dwatman/weather-station/PCB/display_wifi/display_wifi.kicad_pcb

## KiCad design PCB/display_wifi/display_wifi.kicad_pcb (2026-01-17)

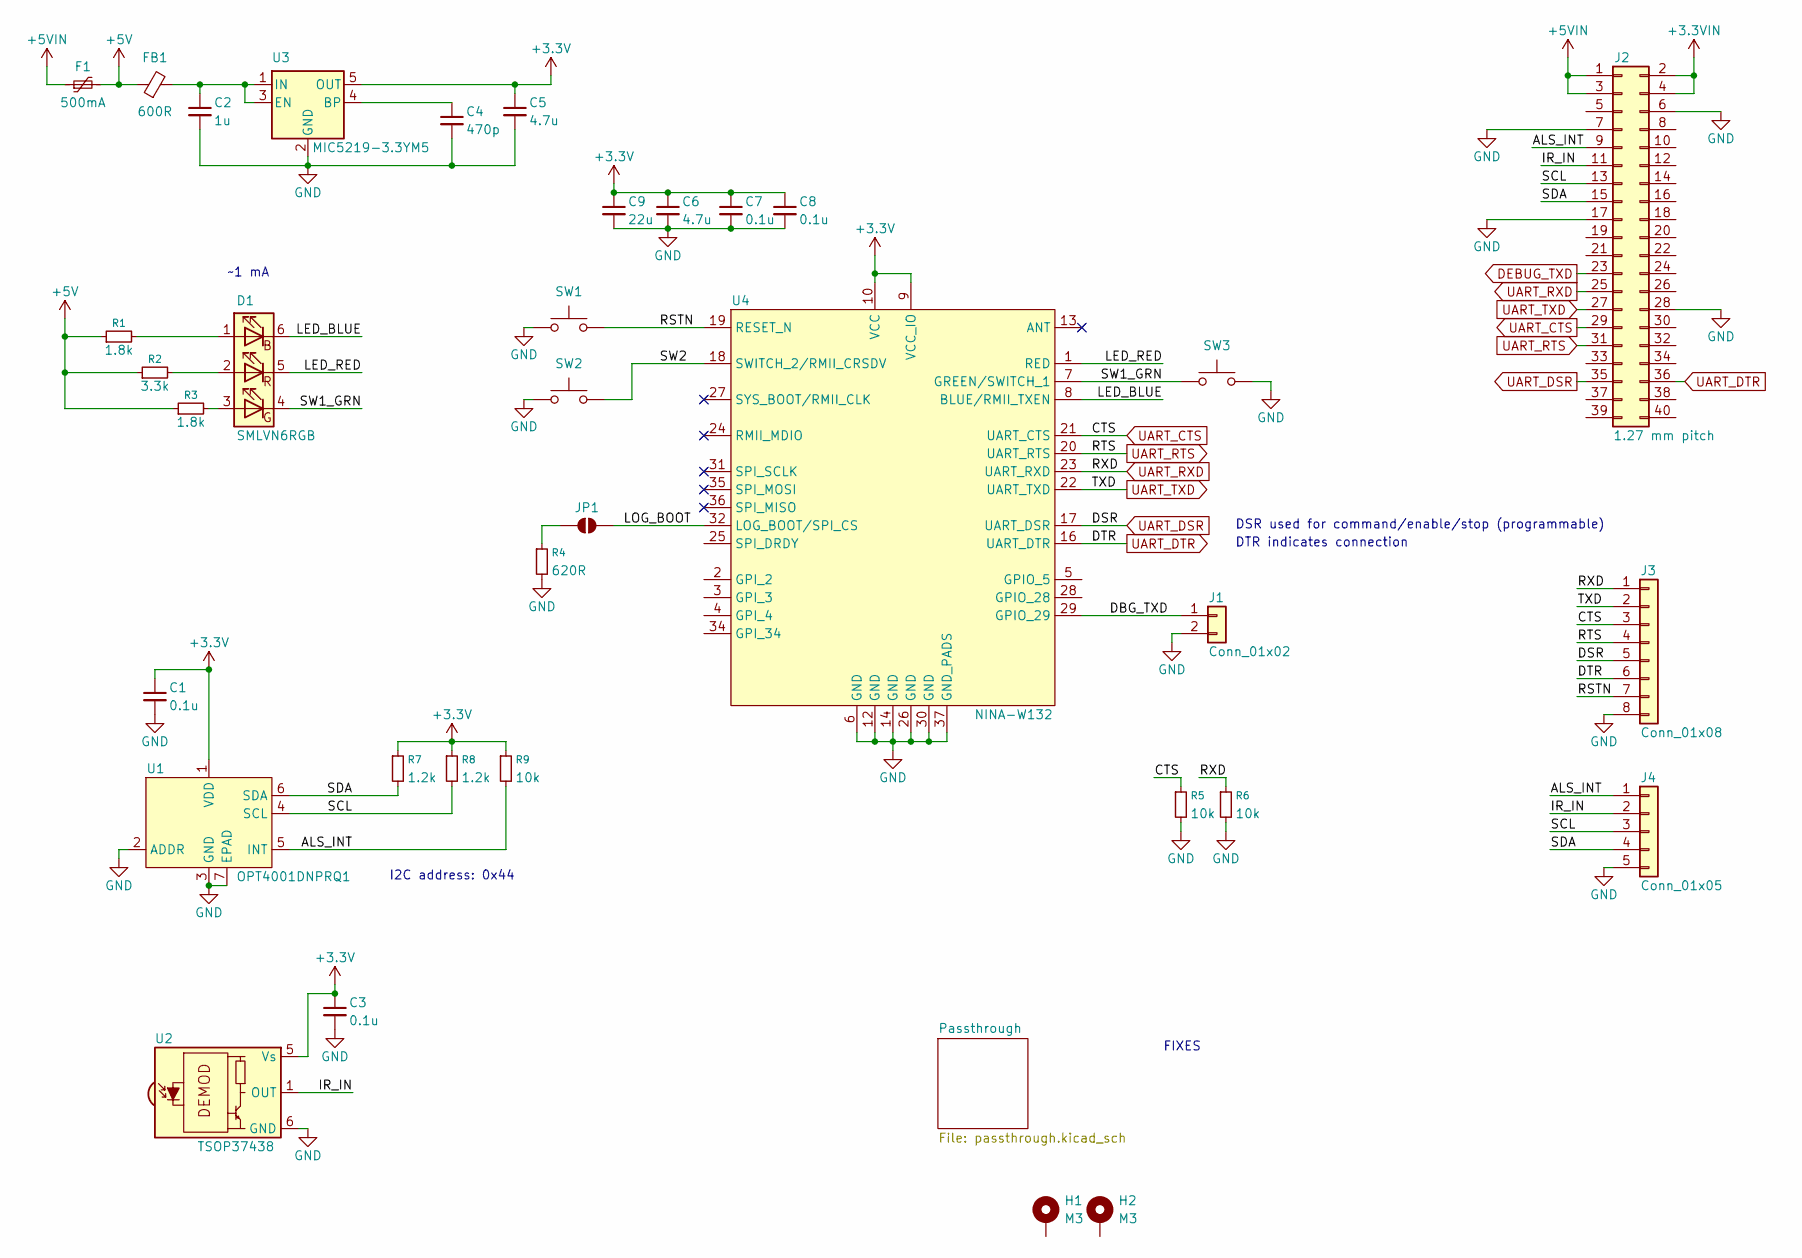
[picture p1: schematic display_wifi.kicad_sch, Wi-Fi Interface for Display]

Parts:
C1, C3, C7, C8: 0.1u; C_0402_1005Metric; MPN CL05B104KA5NNNC; Mouser PN 187-CL05B104KA5NNNC
C2: 1u; C_0402_1005Metric; MPN CL05A105KA5NQNC; Mouser PN 187-CL05A105KA5NQNC
C4: 470p; C_0402_1005Metric; MPN GRM1555C2A471JE01D; Mouser PN 81-GRM1555C2A471JE1D
C5, C6: 4.7u; C_0603_1608Metric; MPN CL10A475KO8NNNC; Mouser PN 187-CL10A475KO8NNNC
C9: 22u; C_1210_3225Metric
D1: SMLVN6RGB; LED_ROHM_SMLVN6; MPN SMLVN6RGB7W1; Mouser PN 755-SMLVN6RGB7W1
F1: 500mA; Fuse_1206_3216Metric; MPN MF-NSMF050-2; Mouser PN 652-MF-NSMF050-2
FB1: 600R; L_0805_2012Metric; MPN BLM21SP601SZ1D; Mouser PN 81-BLM21SP601SZ1D
H1, H2: M3; MountingHole_3.2mm_M3_Pad
J1: Conn_01x02; PinHeader_1x02_P2.54mm_Vertical
J2: 1.27 mm pitch; PinSocket_2x20_P1.27mm_Vertical; MPN 20021311-00040T4LF; Mouser PN 649-221311-00040T4LF
J3: Conn_01x08; PinHeader_1x08_P2.54mm_Vertical
J4: Conn_01x05; PinHeader_1x05_P2.54mm_Vertical
JP1: SolderJumper_2_Open; SolderJumper-2_P1.3mm_Open_TrianglePad1.0x1.5mm
R1, R3: 1.8k; R_0603_1608Metric
R2: 3.3k; R_0603_1608Metric
R4: 620R; R_0603_1608Metric
R5, R6, R9: 10k; R_0603_1608Metric
R7, R8: 1.2k; R_0603_1608Metric
SW1, SW2, SW3: TL3305; SW_Push_1P1T_NO_E-Switch_TL3305AFxxxQG; MPN TL3305BF100QG; Mouser PN 612-TL3305BF100QG
U1: OPT4001DNPRQ1; TI_USON-6-1EP_2x2mm_P0.5mm_EP0.65x1.35mm; MPN OPT4001DNPRQ1; Mouser PN 595-OPT4001DNPRQ1
U2: TSOP37438; Vishay_BELOBOG-4Pin; MPN TSOP37438TT1; Mouser PN 78-TSOP37438TT1
U3: MIC5219-3.3YM5; SOT-23-5; MPN MIC5219-3.3YM5-TR; Mouser PN 998-MIC5219-3.3YM5TR
U4: NINA-W132; ublox_NINA-W1x2; MPN NINA-W132-03B; Mouser PN 377-NINA-W132-03B

Connections:
+3.3V: C1.1, C3.1, C5.1, C6.1, C7.1, C8.1, C9.1, R7.1, R8.1, R9.1, U1.1 (VDD), U2.5 (Vs), U3.5 (OUT), U4.9 (VCC_IO), U4.10 (VCC)
+3.3VIN: J2.2, J2.4
+5V: F1.2, FB1.1, R1.1, R2.1, R3.1
+5VIN: F1.1, J2.1, J2.3
/ALS_INT: J2.9, J4.1, R9.2, U1.5 (INT)
/DBG_TXD: J1.1, U4.29 (GPIO_29)
/IR_IN: J2.11, J4.2, U2.1 (OUT)
/LED_BLUE: D1.6 (BK), U4.8 (BLUE/RMII_TXEN)
/LED_RED: D1.5 (RK), U4.1 (RED)
/LOG_BOOT: JP1.2 (B), U4.32 (LOG_BOOT/SPI_CS)
/RSTN: J3.7, SW1.2, U4.19 (RESET_N)
/SCL: J2.13, J4.3, R8.2, U1.4 (SCL)
/SDA: J2.15, J4.4, R7.2, U1.6 (SDA)
/SW1_GRN: D1.4 (GK), SW3.1, U4.7 (GREEN/SWITCH_1)
/SW2: SW2.2, U4.18 (SWITCH_2/RMII_CRSDV)
DEBUG_TXD: J2.23; also elsewhere on the board
GND: C1.2, C2.2, C3.2, C4.2, C5.2, C6.2, C7.2, C8.2, C9.2, J1.2, J2.6, J2.7, J2.17, J2.28, J3.8, J4.5, R4.2, R5.2, R6.2, SW1.1, SW2.1, SW3.2, U1.2 (ADDR), U1.3 (GND), U1.7 (EPAD), U2.6 (GND), U2.8 (GND), U3.2 (GND), U4.6 (GND), U4.12 (GND), U4.14 (GND), U4.26 (GND), U4.30 (GND), U4.37 (GND_PADS); also elsewhere on the board
unnamed: D1.1 (BA), R1.2
unnamed: D1.3 (GA), R3.2
unnamed: D1.2 (RA), R2.2
unnamed: JP1.1 (A), R4.1
unnamed: C4.1, U3.4 (BP)
unnamed: C2.1, FB1.2, U3.1 (IN), U3.3 (EN)
UART_CTS: J2.29, J3.3, R5.1, U4.21 (UART_CTS)
UART_DSR: J2.35, J3.5, U4.17 (UART_DSR)
UART_DTR: J2.36, J3.6, U4.16 (UART_DTR)
UART_RTS: J2.31, J3.4, U4.20 (UART_RTS)
UART_RXD: J2.25, J3.1, R6.1, U4.23 (UART_RXD)
UART_TXD: J2.27, J3.2, U4.22 (UART_TXD)

Notes on the sheet:
DTR indicates connection
DSR used for command/enable/stop (programmable)
I2C address: 0x44
~1 mA
FIXES

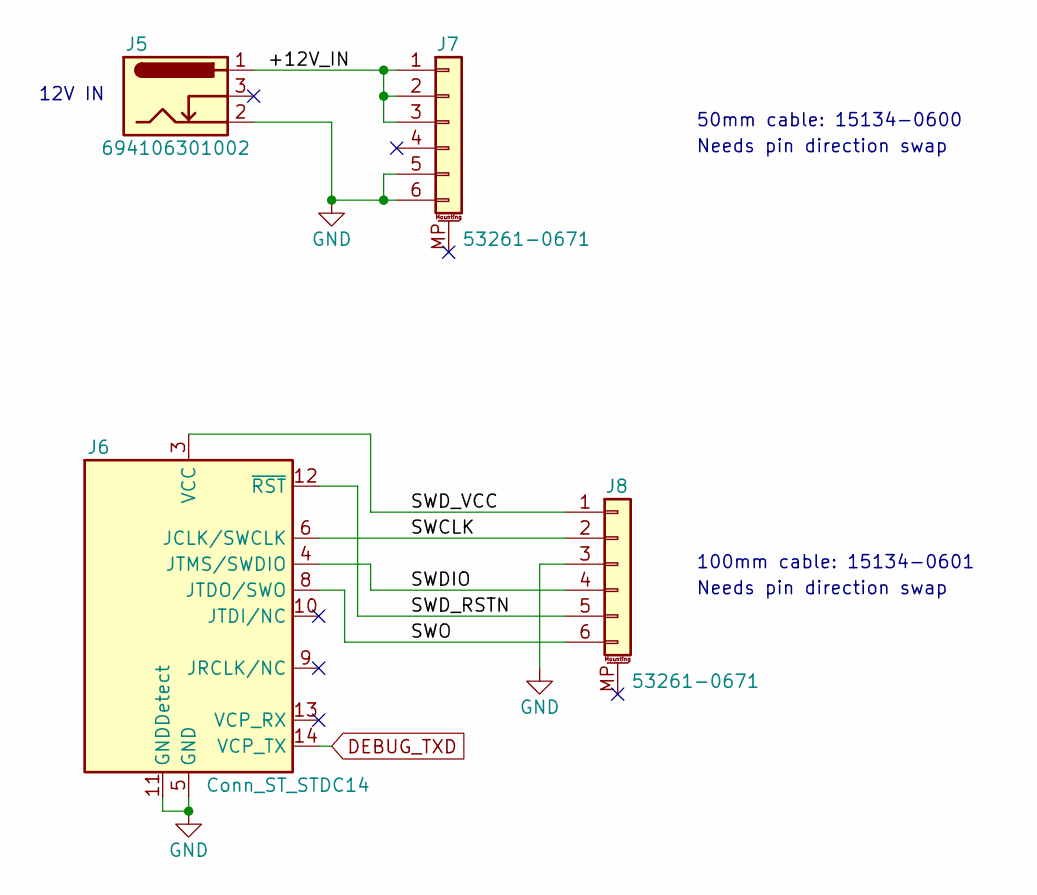
[picture p2: schematic passthrough.kicad_sch]

Parts:
J5: 694106301002; BarrelJack_Wuerth_6941xx301002; MPN 694106301002; Mouser PN 710-694106301002
J6: Conn_ST_STDC14; PinHeader_2x07_P1.27mm_Vertical; MPN 20021111-00014T1LF; Mouser PN 649-200211110014T1LF
J7, J8: 53261-0671; Molex_PicoBlade_53261-0671_1x06-1MP_P1.25mm_Horizontal; MPN 53261-0671; Mouser PN 538-53261-0671

Connections:
/Passthrough/+12V_IN: J5.1, J7.1, J7.2, J7.3
/Passthrough/SWCLK: J6.6 (JCLK/SWCLK), J8.2
/Passthrough/SWDIO: J6.4 (JTMS/SWDIO), J8.4
/Passthrough/SWD_RSTN: J6.12 (~RST), J8.5
/Passthrough/SWD_VCC: J6.3 (VCC), J8.1
/Passthrough/SWO: J6.8 (JTDO/SWO), J8.6
DEBUG_TXD: J6.14 (VCP_TX); also elsewhere on the board
GND: J5.2, J6.5 (GND), J6.7 (GND), J6.11 (GNDDetect), J7.5, J7.6, J8.3; also elsewhere on the board

Notes on the sheet:
50mm cable: 15134-0600
Needs pin direction swap
100mm cable: 15134-0601
12V IN

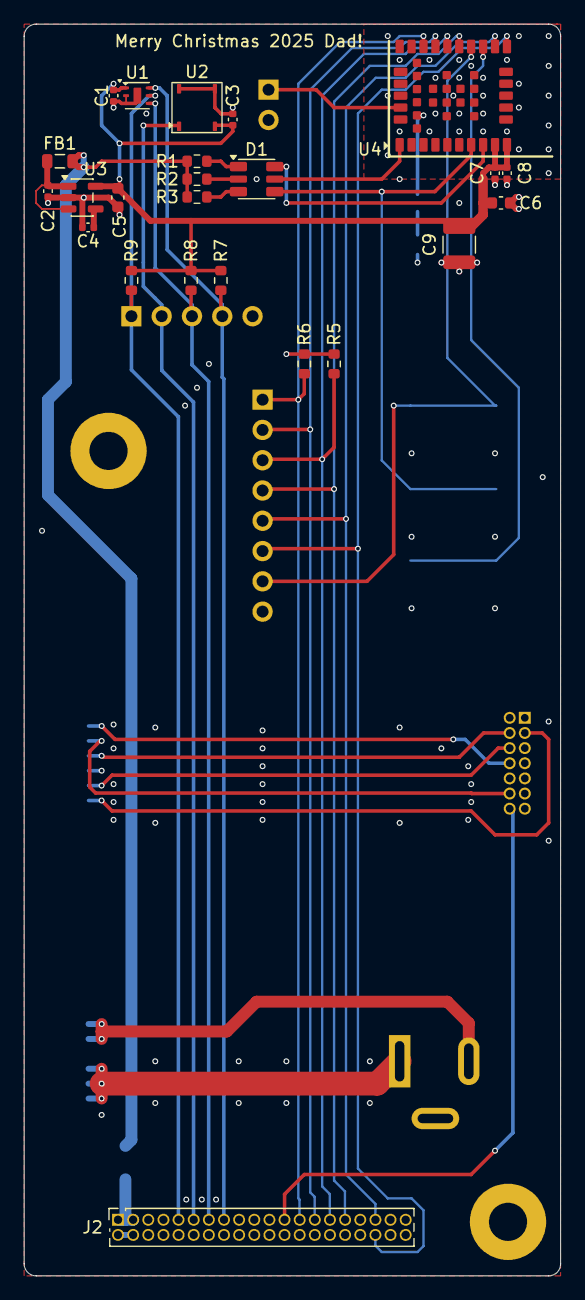
[picture p3: board display_wifi.kicad_pcb from above]

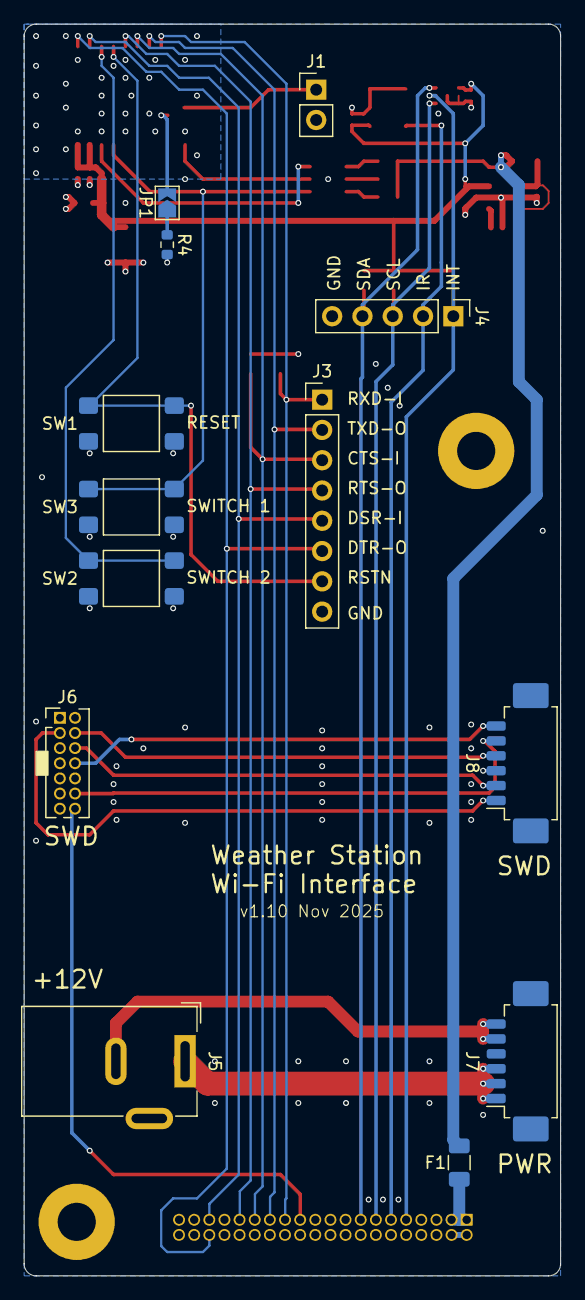
[picture p4: board display_wifi.kicad_pcb from below]

Board: 2 copper layers, 45.0 x 105.0 mm, 39 parts (13 on the bottom side), 35 nets.
