dwatman/weather-station/PCB/sensors_outdoor/sensors_outdoor.kicad_pcb

## KiCad design PCB/sensors_outdoor/sensors_outdoor.kicad_pcb (2025-11-24)

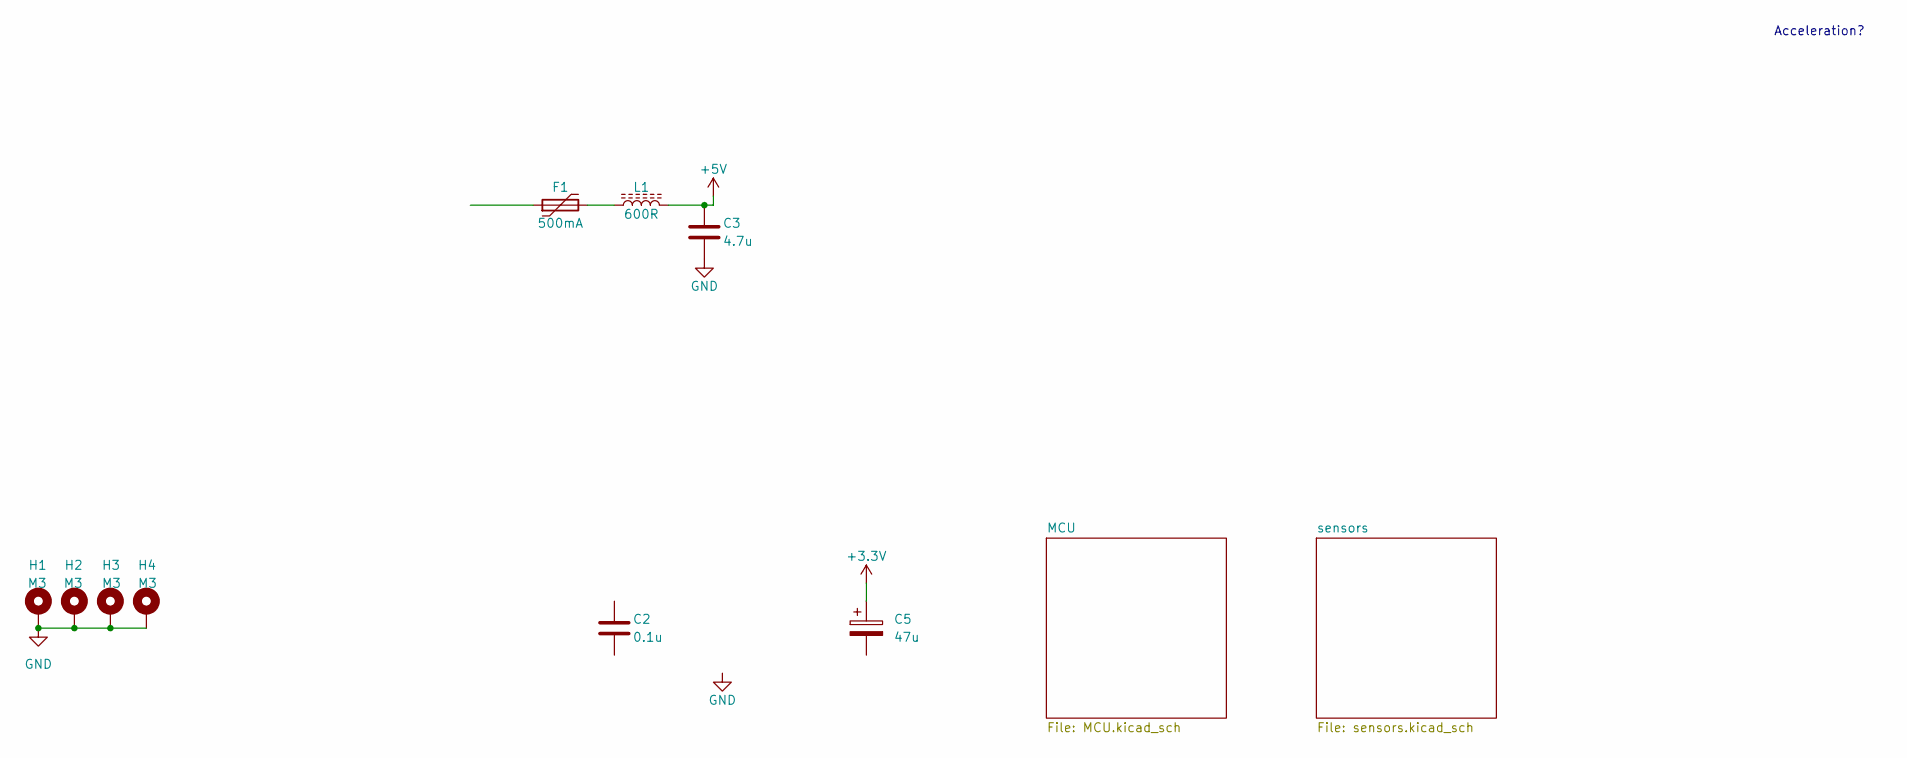
[picture p5: schematic sensors_outdoor.kicad_sch, Outdoor Sensor Board]

Parts:
C2: 0.1u; C_0402_1005Metric
C3: 4.7u; C_0805_2012Metric
C5: 47u; CP_EIA-7343-31_Kemet-D; MPN T491D476K010AT; Mouser PN 80-T491D476K010
F1: 500mA; Fuse_0805_2012Metric
H1, H2, H3, H4: M3; MountingHole_3.2mm_M3_Pad
L1: 600R; L_0805_2012Metric; MPN HZ0805E601R-10; Mouser PN 875-HZ0805E601R-10

Connections:
+3.3V: C5.1; also elsewhere on the board
+5V: C3.1, L1.2
GND: C3.2, H1.1, H2.1, H3.1, H4.1; also elsewhere on the board
unnamed: F1.2, L1.1

Notes on the sheet:
Acceleration?

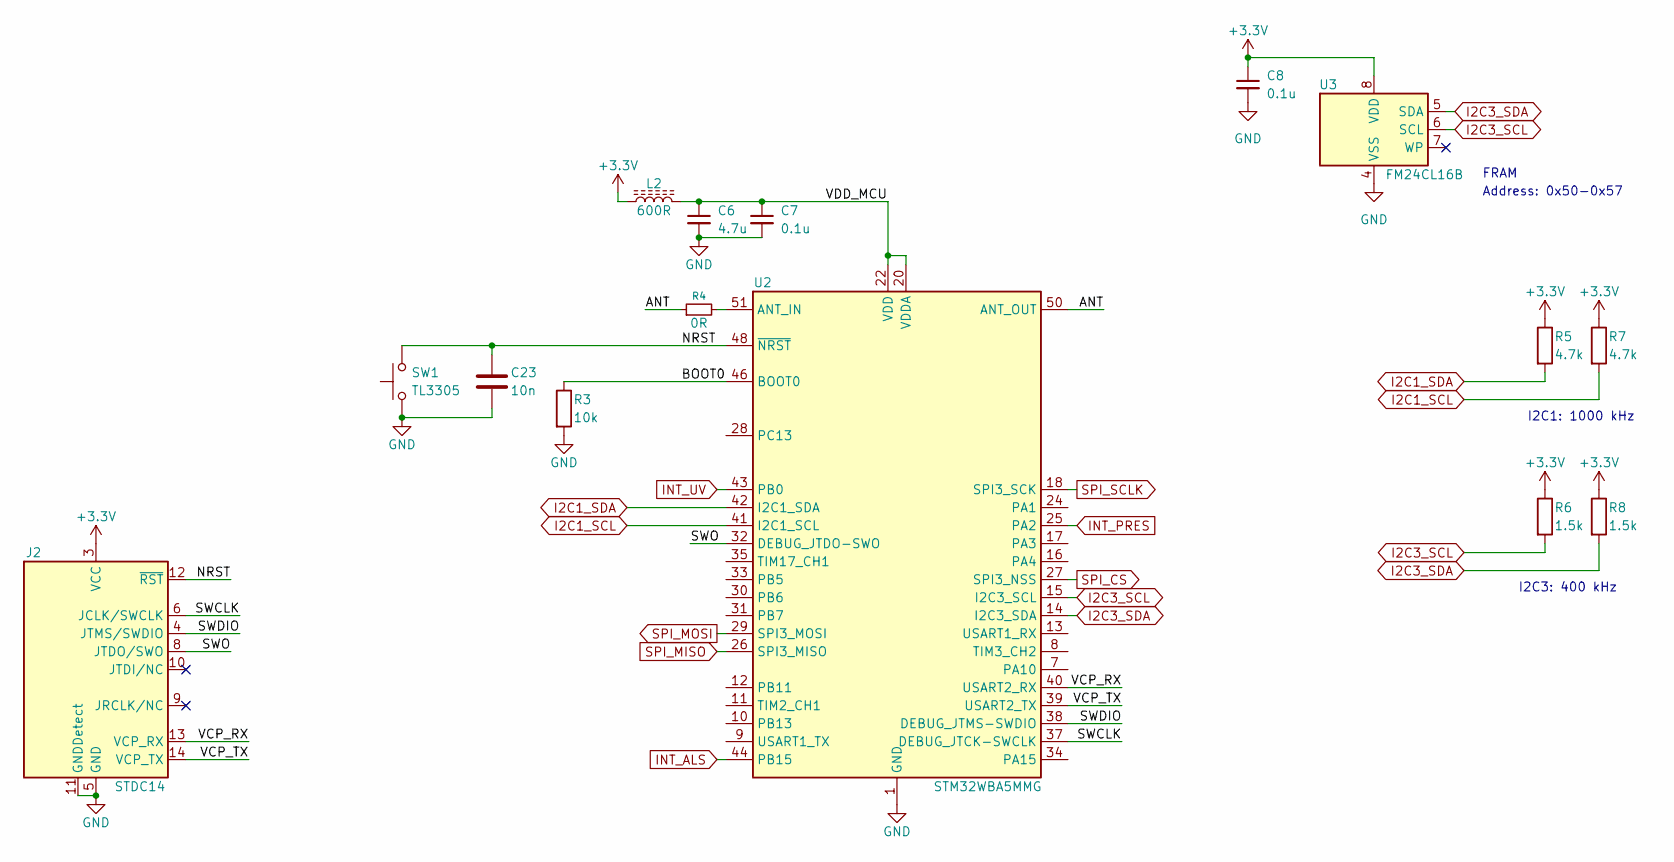
[picture p6: schematic MCU.kicad_sch]

Parts:
C6: 4.7u; C_0805_2012Metric
C7, C8: 0.1u; C_0402_1005Metric
C23: 10n; C_0402_1005Metric
J2: STDC14; SAMTEC_FTSH-107-01-L-DV-K-A; MPN FTSH-107-01-L-DV-K-A; Mouser PN 200-FTSH10701LDVKA
L2: 600R; L_0805_2012Metric; MPN HZ0805E601R-10; Mouser PN 875-HZ0805E601R-10
R3: 10k; R_0603_1608Metric
R4: 0R; R_0402_1005Metric
R5, R7: 4.7k; R_0603_1608Metric
R6, R8: 1.5k; R_0603_1608Metric
SW1: TL3305; SW_Push_1P1T_NO_E-Switch_TL3305AFxxxQG; MPN TL3305AF260QG; Mouser PN 612-TL3305AF260QG
U2: STM32WBA5MMG; MPN STM32WBA5MMGH6TR; Mouser PN 511-STM32WBA5MMGH6TR
U3: FM24CL16B; SOIC-8_3.9x4.9mm_P1.27mm; MPN FM24CL16B-G; Mouser PN 877-FM24CL16B-G

Connections:
+3.3V: C8.1, J2.3 (VCC), L2.1, R5.1, R6.1, R7.1, R8.1, U3.8 (VDD); also elsewhere on the board
/MCU/ANT: R4.1, U2.50 (ANT_OUT)
/MCU/BOOT0: R3.1, U2.46 (BOOT0)
/MCU/NRST: C23.1, J2.12 (~RST), SW1.2, U2.48 (~NRST)
/MCU/SWCLK: J2.6 (JCLK/SWCLK), U2.37 (DEBUG_JTCK-SWCLK)
/MCU/SWDIO: J2.4 (JTMS/SWDIO), U2.38 (DEBUG_JTMS-SWDIO)
/MCU/SWO: J2.8 (JTDO/SWO), U2.32 (DEBUG_JTDO-SWO)
/MCU/VCP_RX: J2.13 (VCP_RX), U2.40 (USART2_RX)
/MCU/VCP_TX: J2.14 (VCP_TX), U2.39 (USART2_TX)
/MCU/VDD_MCU: C6.1, C7.1, L2.2, U2.20 (VDDA), U2.22 (VDD)
GND: C6.2, C7.2, C8.2, C23.2, J2.5 (GND), J2.7 (GND), J2.11 (GNDDetect), R3.2, SW1.1, U2.1 (GND), U2.6 (GND), U2.19 (GND), U2.21 (GND), U2.23 (GND), U2.36 (GND), U2.45 (GND), U2.47 (GND), U2.49 (GND), U2.52 (GND), U2.53 (GND), U2.54 (GND), U2.55 (GND), U2.57 (GND), U2.58 (GND), U2.60 (GND), U2.61 (GND), U2.62 (GND), U2.63 (GND), U2.64 (GND), U2.65 (GND), U2.66 (GND), U2.67 (GND), U2.68 (GND), U2.69 (GND), U2.70 (GND), U2.71 (GND), U2.72 (GND), U2.73 (GND), U2.74 (GND), U2.75 (GND), U2.76 (GND), U3.4 (VSS); also elsewhere on the board
I2C1_SCL: R7.2, U2.41 (I2C1_SCL); also elsewhere on the board
I2C1_SDA: R5.2, U2.42 (I2C1_SDA); also elsewhere on the board
I2C3_SCL: R6.2, U2.15 (I2C3_SCL), U3.6 (SCL)
I2C3_SDA: R8.2, U2.14 (I2C3_SDA), U3.5 (SDA)
INT_ALS: U2.44 (PB15); also elsewhere on the board
INT_PRES: U2.25 (PA2); also elsewhere on the board
INT_UV: U2.43 (PB0); also elsewhere on the board
unnamed: R4.2, U2.51 (ANT_IN)
SPI_CS: U2.27 (SPI3_NSS); also elsewhere on the board
SPI_MISO: U2.26 (SPI3_MISO); also elsewhere on the board
SPI_MOSI: U2.29 (SPI3_MOSI); also elsewhere on the board
SPI_SCLK: U2.18 (SPI3_SCK); also elsewhere on the board

Notes on the sheet:
I2C3: 400 kHz
Address: 0x50-0x57
I2C1: 1000 kHz
FRAM

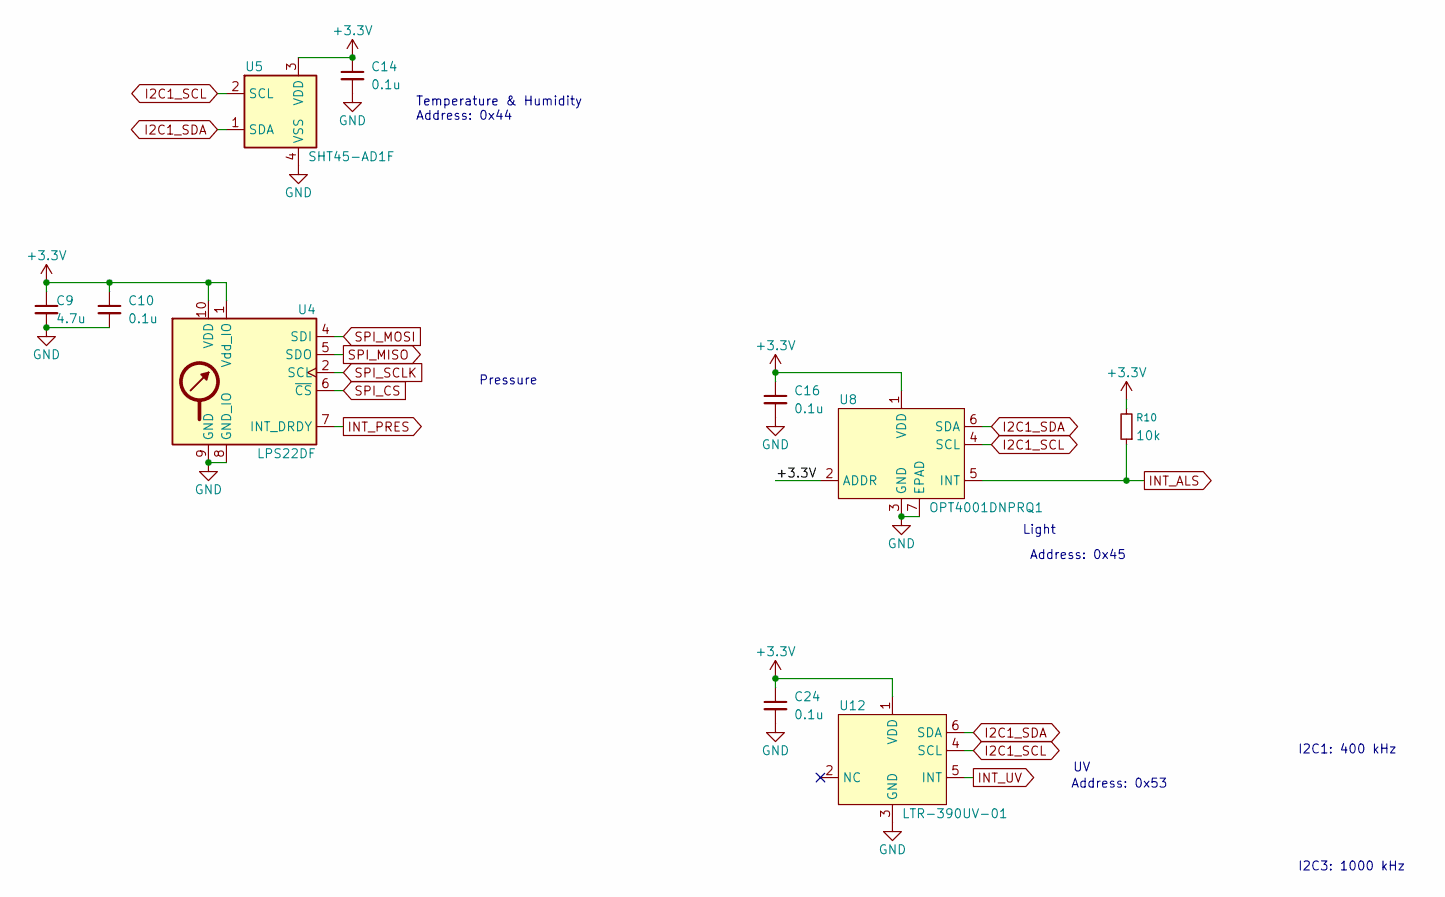
[picture p7: schematic sensors.kicad_sch]

Parts:
C9: 4.7u; C_0805_2012Metric
C10, C14, C16, C24: 0.1u; C_0402_1005Metric
R10: 10k; R_0603_1608Metric
U4: LPS22DF; ST_HLGA-10L_2x2mm_P0.5mm_LayoutBorder3x2y; MPN LPS22DFTR; Mouser PN 511-LPS22DFTR
U5: SHT45-AD1F; Sensirion_DFN-4_1.5x1.5mm_P0.8mm_SHT4x_NoCentralPad; MPN SHT45-AD1F-R2; Mouser PN 403-SHT45-AD1F-R2
U8: OPT4001DNPRQ1; TI_USON-6-1EP_2x2mm_P0.5mm_EP0.65x1.35mm; MPN OPT4001DNPRQ1; Mouser PN 595-OPT4001DNPRQ1
U12: LTR-390UV-01; Liteon_LTR-390UV-01; MPN LTR-390UV-01; Mouser PN 859-LTR390UV01

Connections:
+3.3V: C9.1, C10.1, C14.1, C16.1, C24.1, R10.2, U4.1 (Vdd_IO), U4.10 (VDD), U5.3 (VDD), U8.1 (VDD), U8.2 (ADDR), U12.1 (VDD); also elsewhere on the board
GND: C9.2, C10.2, C14.2, C16.2, C24.2, U4.3 (GND), U4.8 (GND_IO), U4.9 (GND), U5.4 (VSS), U8.3 (GND), U8.7 (EPAD), U12.3 (GND); also elsewhere on the board
I2C1_SCL: U5.2 (SCL), U8.4 (SCL), U12.4 (SCL); also elsewhere on the board
I2C1_SDA: U5.1 (SDA), U8.6 (SDA), U12.6 (SDA); also elsewhere on the board
INT_ALS: R10.1, U8.5 (INT); also elsewhere on the board
INT_PRES: U4.7 (INT_DRDY); also elsewhere on the board
INT_UV: U12.5 (INT); also elsewhere on the board
SPI_CS: U4.6 (~CS); also elsewhere on the board
SPI_MISO: U4.5 (SDO); also elsewhere on the board
SPI_MOSI: U4.4 (SDI); also elsewhere on the board
SPI_SCLK: U4.2 (SCL); also elsewhere on the board

Notes on the sheet:
Address: 0x53
Address: 0x44
Light
Pressure
I2C1: 400 kHz
Address: 0x45
I2C3: 1000 kHz
Temperature & Humidity

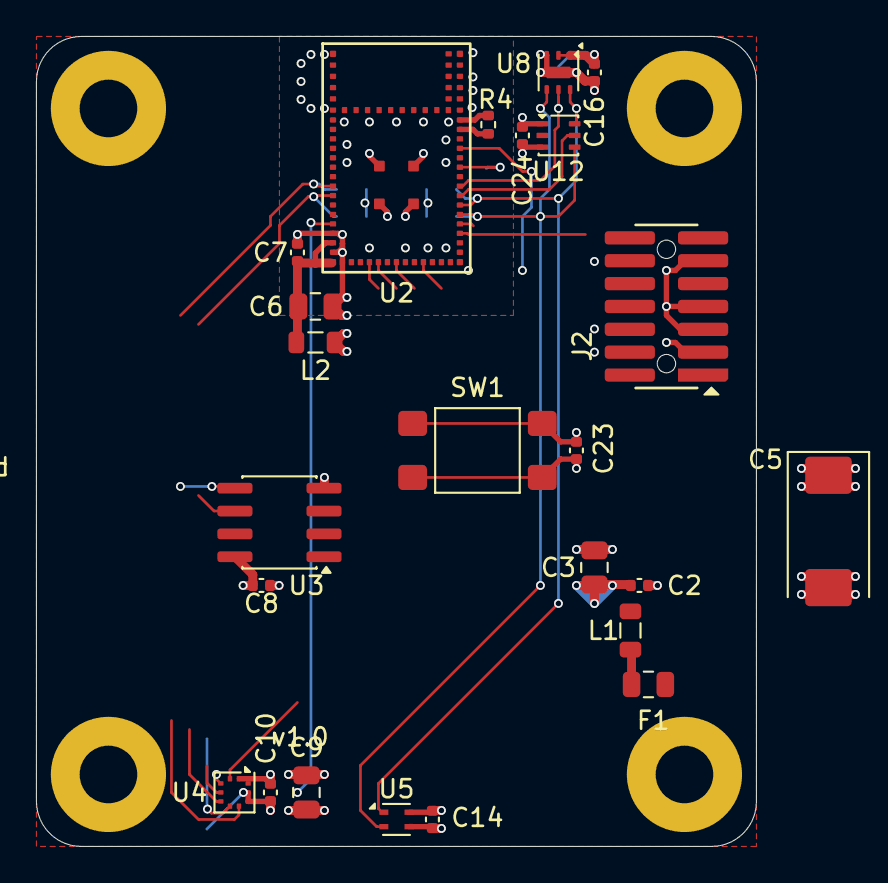
[picture p8: board sensors_outdoor.kicad_pcb from above]

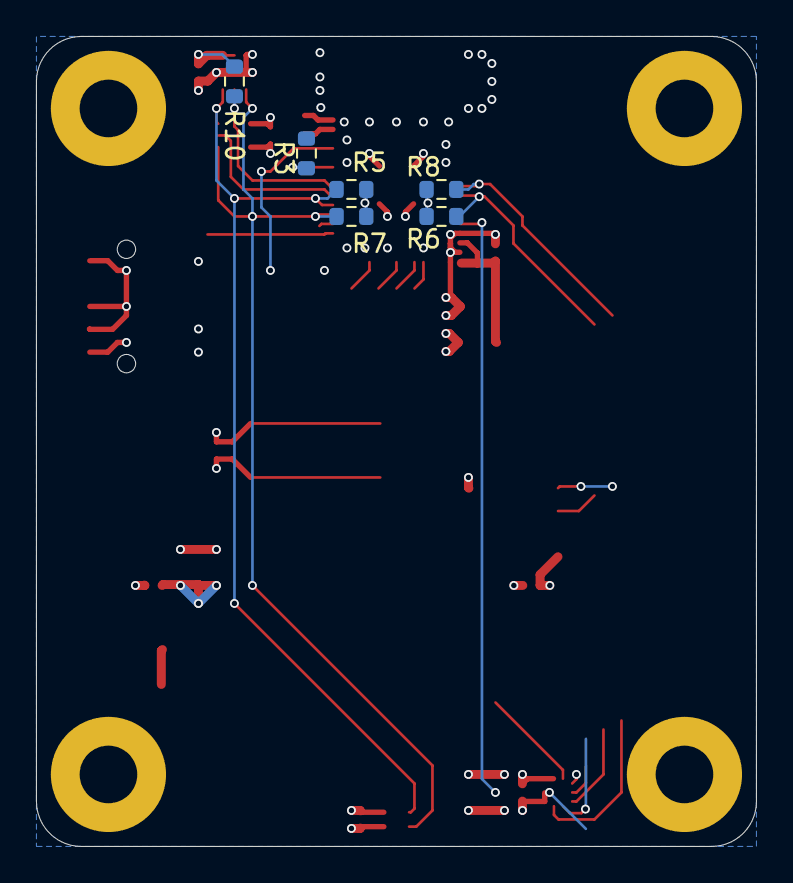
[picture p9: board sensors_outdoor.kicad_pcb from below]

Board: 4 copper layers, 40.0 x 45.0 mm, 34 parts (6 on the bottom side), 25 nets.
