dwatman/weather-station/PCB/solar_power/solar_power.kicad_pcb

## KiCad design PCB/solar_power/solar_power.kicad_pcb (2025-11-09)

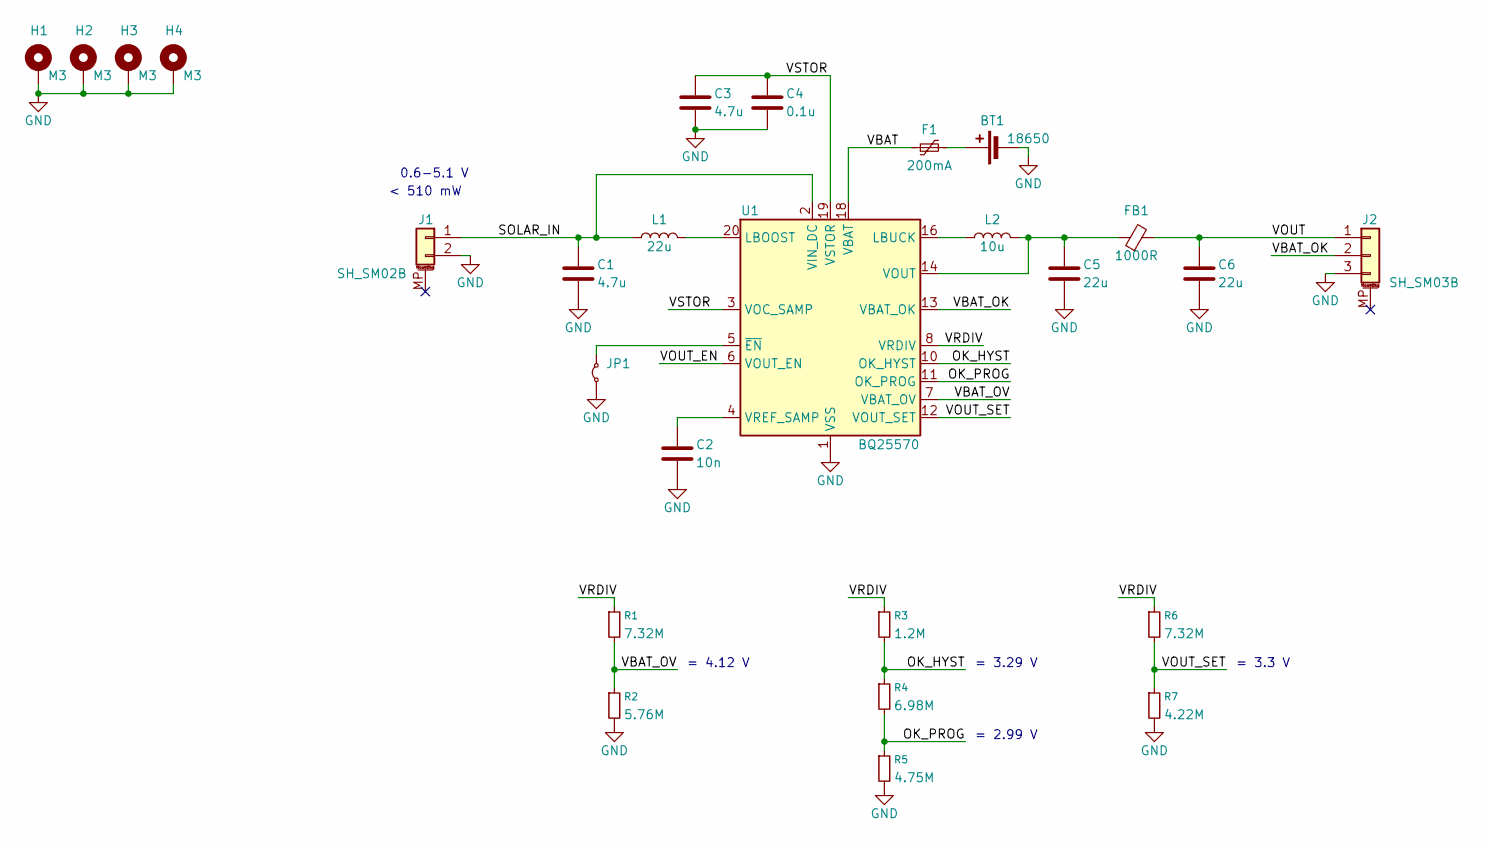
[picture p10: schematic solar_power.kicad_sch]

Parts:
BT1: 18650; Keystone_1043P_1x18650; MPN 1043P; Mouser PN 534-1043P
C1, C3: 4.7u; C_0805_2012Metric
C2: 10n; C_0402_1005Metric
C4: 0.1u; C_0402_1005Metric
C5, C6: 22u; C_0805_2012Metric; MPN CL21A226MAYNNNE; Mouser PN 187-CL21A226MAYNNNE
F1: 200mA; Fuse_1206_3216Metric; MPN 0ZCJ0020FF2E; Mouser PN 530-0ZCJ0020FF2E
FB1: 1000R; L_0603_1608Metric; MPN BLM18AG102SN1D; Mouser PN 81-BLM11A102S
H1, H2, H3, H4: M3; MountingHole_3.2mm_M3_Pad
J1: SH_SM02B; JST_SH_SM02B-SRSS-TB_1x02-1MP_P1.00mm_Horizontal; MPN SM02B-SRSS-TB(LF)(SN); Mouser PN 306-SM02BSRSSTBLFSN
J2: SH_SM03B; JST_SH_SM03B-SRSS-TB_1x03-1MP_P1.00mm_Horizontal; MPN SM03B-SRSS-TB(LF)(SN); Mouser PN 306-SM03BSRSSTBLFSNP
JP1: Jumper_2_Small_Bridged; SolderJumper-2_P1.3mm_Open_TrianglePad1.0x1.5mm
L1: 22u; L_Abracon_ASPI-4030S; MPN ASPI-4030S-220M-T; Mouser PN 815-ASPI-4030S-220MT
L2: 10u; L_Abracon_ASPI-3012S; MPN ASPI-3012S-100M-T; Mouser PN 815-ASPI-3012S-100MT
R1, R6: 7.32M; R_0805_2012Metric; MPN RC0805FR-077M32L; Mouser PN 603-RC0805FR-077M32L
R2: 5.76M; R_0805_2012Metric; MPN RC0805FR-075M76L; Mouser PN 603-RC0805FR-075M76L
R3: 1.2M; R_0805_2012Metric; MPN RC0805FR-101M2L; Mouser PN 603-RC0805FR-101M2L
R4: 6.98M; R_0805_2012Metric; MPN RC0805FR-076M98L; Mouser PN 603-RC0805FR-076M98L
R5: 4.75M; R_0805_2012Metric; MPN RC0805FR-074M75L; Mouser PN 603-RC0805FR-074M75L
R7: 4.22M; R_0805_2012Metric; MPN RC0805FR-074M22L; Mouser PN 603-RC0805FR-074M22L
U1: BQ25570; QFN-20-1EP_3.5x3.5mm_P0.5mm_EP2x2mm; MPN BQ25570RGRR; Mouser PN 595-BQ25570RGRR

Connections:
/OK_HYST: R3.2, R4.1, U1.10 (OK_HYST)
/OK_PROG: R4.2, R5.1, U1.11 (OK_PROG)
/SOLAR_IN: C1.1, J1.1, L1.1, U1.2 (VIN_DC)
/VBAT: F1.1, U1.18 (VBAT)
/VBAT_OK: J2.2, U1.13 (VBAT_OK)
/VBAT_OV: R1.2, R2.1, U1.7 (VBAT_OV)
/VOUT: C6.1, FB1.2, J2.1
/VOUT_EN: U1.6 (VOUT_EN)
/VOUT_SET: R6.2, R7.1, U1.12 (VOUT_SET)
/VRDIV: R1.1, R3.1, R6.1, U1.8 (VRDIV)
/VSTOR: C3.1, C4.1, U1.3 (VOC_SAMP), U1.19 (VSTOR)
GND: BT1.2 (-), C1.2, C2.2, C3.2, C4.2, C5.2, C6.2, H1.1, H2.1, H3.1, H4.1, J1.2, J2.3, JP1.1 (A), R2.2, R5.2, R7.2, U1.1 (VSS), U1.9 (VSS), U1.15 (VSS), U1.17 (VSS), U1.21 (VSS)
unnamed: BT1.1 (+), F1.2
unnamed: JP1.2 (B), U1.5 (~EN)
unnamed: L1.2, U1.20 (LBOOST)
unnamed: L2.1, U1.16 (LBUCK)
unnamed: C5.1, FB1.1, L2.2, U1.14 (VOUT)
unnamed: C2.1, U1.4 (VREF_SAMP)

Notes on the sheet:
= 2.99 V
0.6-5.1 V
= 3.3 V
= 3.29 V
= 4.12 V
< 510 mW

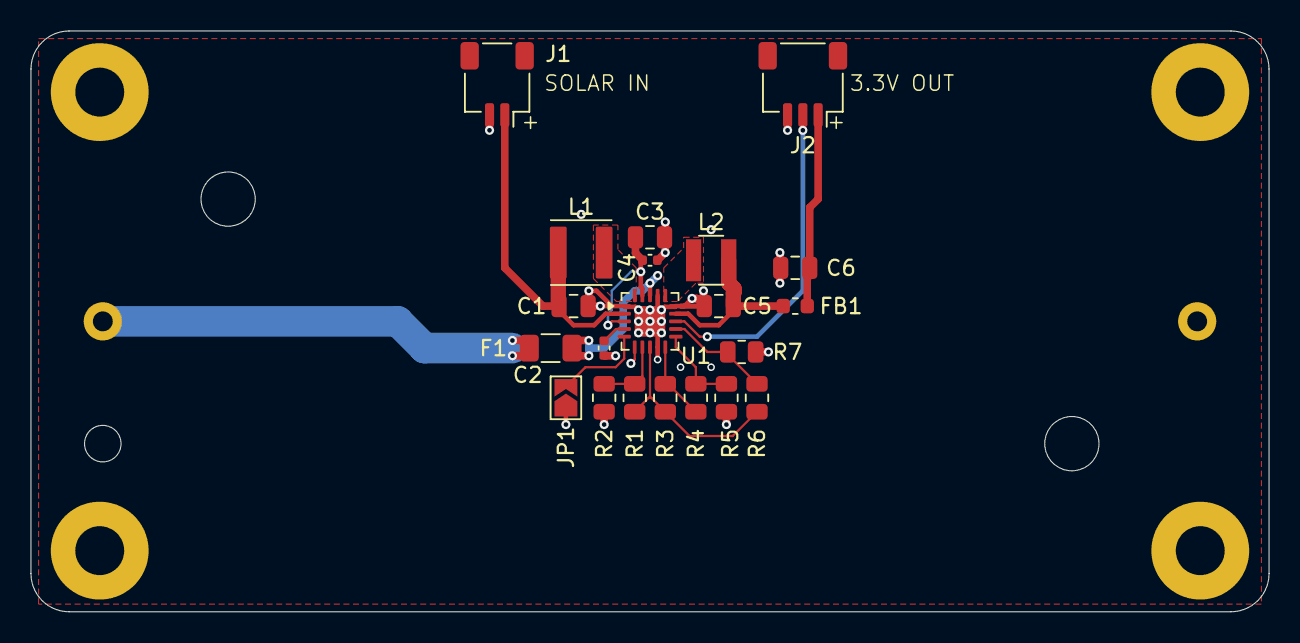
[picture p11: board solar_power.kicad_pcb from above]

Board: 2 copper layers, 81.0 x 38.0 mm, 26 parts (1 on the bottom side), 17 nets.
