dwatman/weather-station/PCB/sensors_indoor/sensors_indoor.kicad_pcb

## KiCad design PCB/sensors_indoor/sensors_indoor.kicad_pcb (2025-11-09)

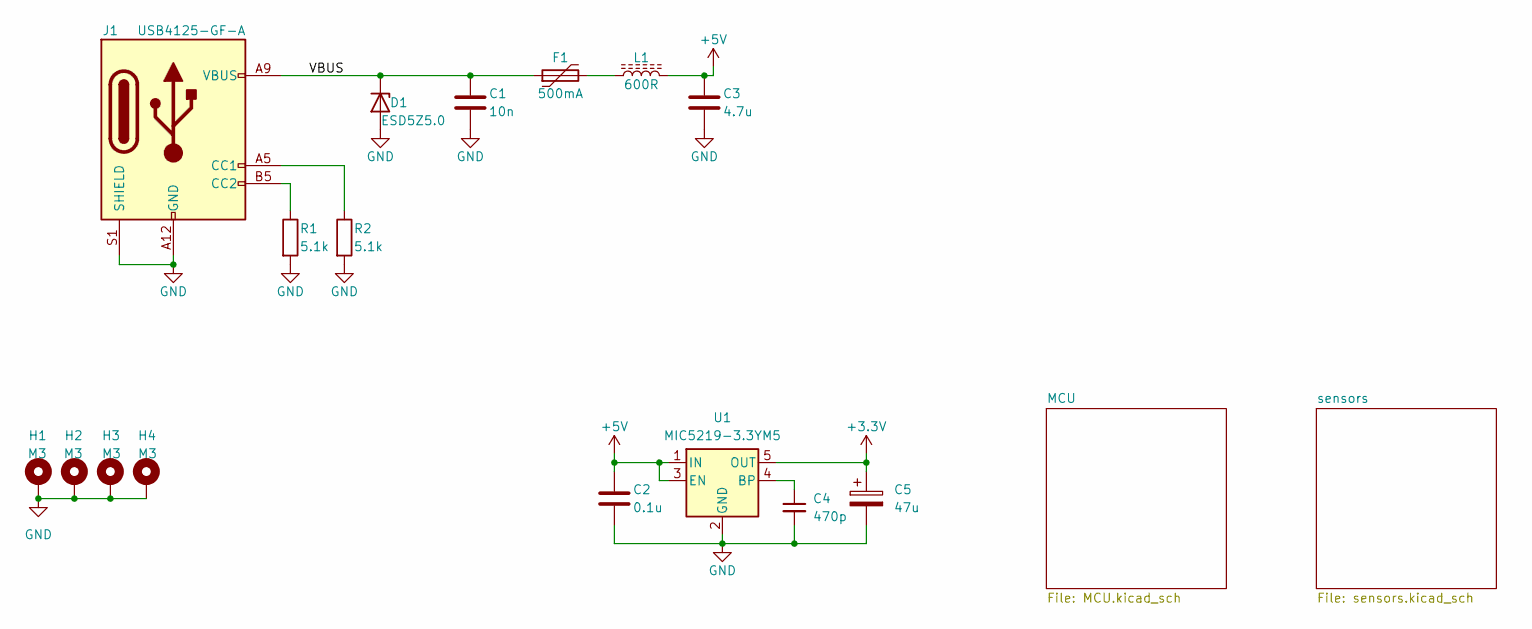
[picture p12: schematic sensors_indoor.kicad_sch, Indoor Sensor Board]

Parts:
C1: 10n; C_0402_1005Metric
C2: 0.1u; C_0402_1005Metric
C3: 4.7u; C_0805_2012Metric
C4: 470p; C_0402_1005Metric
C5: 47u; CP_EIA-7343-31_Kemet-D; MPN T491D476K010AT; Mouser PN 80-T491D476K010
D1: ESD5Z5.0; D_SOD-523; MPN ESD5Z5.0T1G; Mouser PN 863-ESD5Z5.0T1G
F1: 500mA; Fuse_1206_3216Metric; MPN MF-NSMF050-2; Mouser PN 652-MF-NSMF050-2
H1, H2, H3, H4: M3; MountingHole_3.2mm_M3_Pad
J1: USB4125-GF-A; USB_C_Receptacle_GCT_USB4125-xx-x-0190_6P_TopMnt_Horizontal; MPN USB4125-GF-A; Mouser PN 640-USB4125-GF-A
L1: 600R; L_0805_2012Metric; MPN HZ0805E601R-10; Mouser PN 875-HZ0805E601R-10
R1, R2: 5.1k; R_0603_1608Metric
U1: MIC5219-3.3YM5; SOT-23-5; MPN MIC5219-3.3YM5-TR; Mouser PN 998-MIC5219-3.3YM5TR

Connections:
+3.3V: C5.1, U1.5 (OUT); also elsewhere on the board
+5V: C2.1, C3.1, L1.2, U1.1 (IN), U1.3 (EN); also elsewhere on the board
/VBUS: C1.1, D1.1 (K), F1.1, J1.A9 (VBUS), J1.B9 (VBUS)
GND: C1.2, C2.2, C3.2, C4.2, C5.2, D1.2 (A), H1.1, H2.1, H3.1, H4.1, J1.A12 (GND), J1.B12 (GND), J1.S1 (SHIELD), R1.2, R2.2, U1.2 (GND); also elsewhere on the board
unnamed: F1.2, L1.1
unnamed: J1.A5 (CC1), R2.1
unnamed: J1.B5 (CC2), R1.1
unnamed: C4.1, U1.4 (BP)
