dwatman/weather-station/PCB/sensors_indoor/sensors_indoor.kicad_pcb

## KiCad design PCB/sensors_indoor/sensors_indoor.kicad_pcb (continued)

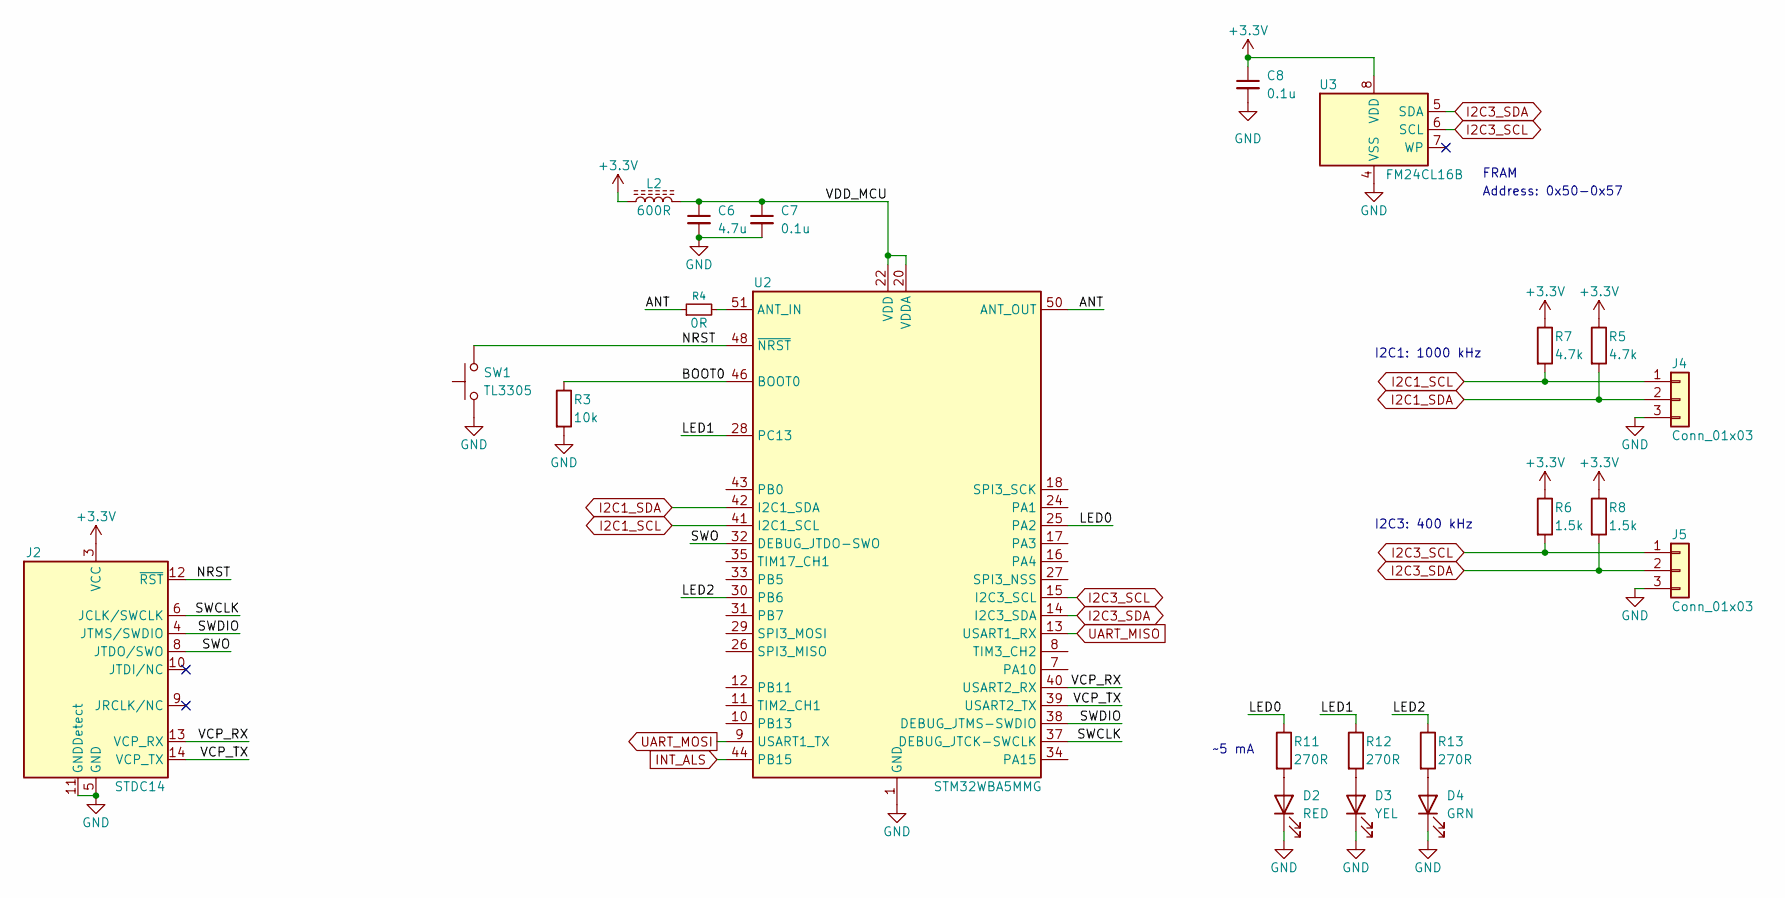
[picture p13: schematic MCU.kicad_sch]

Parts:
C6: 4.7u; C_0805_2012Metric
C7, C8: 0.1u; C_0402_1005Metric
D2: RED; LED_0805_2012Metric; MPN LS R976-NR-1-0-20-R18
D3: YEL; LED_0805_2012Metric; MPN LY R976-PS-36-0-20-R18
D4: GRN; LED_0805_2012Metric; MPN LG R971-KN-1-0-20-R18
J2: STDC14; SAMTEC_FTSH-107-01-L-DV-K-A; MPN FTSH-107-01-L-DV-K-A; Mouser PN 200-FTSH10701LDVKA
J4, J5: Conn_01x03; PinHeader_1x03_P2.54mm_Vertical
L2: 600R; L_0805_2012Metric; MPN HZ0805E601R-10; Mouser PN 875-HZ0805E601R-10
R3: 10k; R_0603_1608Metric
R4: 0R; R_0402_1005Metric
R5, R7: 4.7k; R_0603_1608Metric
R6, R8: 1.5k; R_0603_1608Metric
R11, R12, R13: 270R; R_0603_1608Metric
SW1: TL3305; SW_Push_1P1T_NO_E-Switch_TL3305AFxxxQG; MPN TL3305AF260QG; Mouser PN 612-TL3305AF260QG
U2: STM32WBA5MMG; MPN STM32WBA5MMGH6TR; Mouser PN 511-STM32WBA5MMGH6TR
U3: FM24CL16B; SOIC-8_3.9x4.9mm_P1.27mm; MPN FM24CL16B-G; Mouser PN 877-FM24CL16B-G

Connections:
+3.3V: C8.1, J2.3 (VCC), L2.1, R5.1, R6.1, R7.1, R8.1, U3.8 (VDD); also elsewhere on the board
/MCU/ANT: R4.1, U2.50 (ANT_OUT)
/MCU/BOOT0: R3.1, U2.46 (BOOT0)
/MCU/LED0: R11.1, U2.25 (PA2)
/MCU/LED1: R12.1, U2.28 (PC13)
/MCU/LED2: R13.1, U2.30 (PB6)
/MCU/NRST: J2.12 (~RST), SW1.2, U2.48 (~NRST)
/MCU/SWCLK: J2.6 (JCLK/SWCLK), U2.37 (DEBUG_JTCK-SWCLK)
/MCU/SWDIO: J2.4 (JTMS/SWDIO), U2.38 (DEBUG_JTMS-SWDIO)
/MCU/SWO: J2.8 (JTDO/SWO), U2.32 (DEBUG_JTDO-SWO)
/MCU/VCP_RX: J2.13 (VCP_RX), U2.40 (USART2_RX)
/MCU/VCP_TX: J2.14 (VCP_TX), U2.39 (USART2_TX)
/MCU/VDD_MCU: C6.1, C7.1, L2.2, U2.20 (VDDA), U2.22 (VDD)
GND: C6.2, C7.2, C8.2, D2.1 (K), D3.1 (K), D4.1 (K), J2.5 (GND), J2.7 (GND), J2.11 (GNDDetect), J4.3, J5.3, R3.2, SW1.1, U2.1 (GND), U2.6 (GND), U2.19 (GND), U2.21 (GND), U2.23 (GND), U2.36 (GND), U2.45 (GND), U2.47 (GND), U2.49 (GND), U2.52 (GND), U2.53 (GND), U2.54 (GND), U2.55 (GND), U2.57 (GND), U2.58 (GND), U2.60 (GND), U2.61 (GND), U2.62 (GND), U2.63 (GND), U2.64 (GND), U2.65 (GND), U2.66 (GND), U2.67 (GND), U2.68 (GND), U2.69 (GND), U2.70 (GND), U2.71 (GND), U2.72 (GND), U2.73 (GND), U2.74 (GND), U2.75 (GND), U2.76 (GND), U3.4 (VSS); also elsewhere on the board
I2C1_SCL: J4.1, R7.2, U2.41 (I2C1_SCL); also elsewhere on the board
I2C1_SDA: J4.2, R5.2, U2.42 (I2C1_SDA); also elsewhere on the board
I2C3_SCL: J5.1, R6.2, U2.15 (I2C3_SCL), U3.6 (SCL); also elsewhere on the board
I2C3_SDA: J5.2, R8.2, U2.14 (I2C3_SDA), U3.5 (SDA); also elsewhere on the board
INT_ALS: U2.44 (PB15); also elsewhere on the board
unnamed: D2.2 (A), R11.2
unnamed: D3.2 (A), R12.2
unnamed: D4.2 (A), R13.2
unnamed: R4.2, U2.51 (ANT_IN)
UART_MISO: U2.13 (USART1_RX); also elsewhere on the board
UART_MOSI: U2.9 (USART1_TX); also elsewhere on the board

Notes on the sheet:
I2C3: 400 kHz
Address: 0x50-0x57
I2C1: 1000 kHz
FRAM
~5 mA

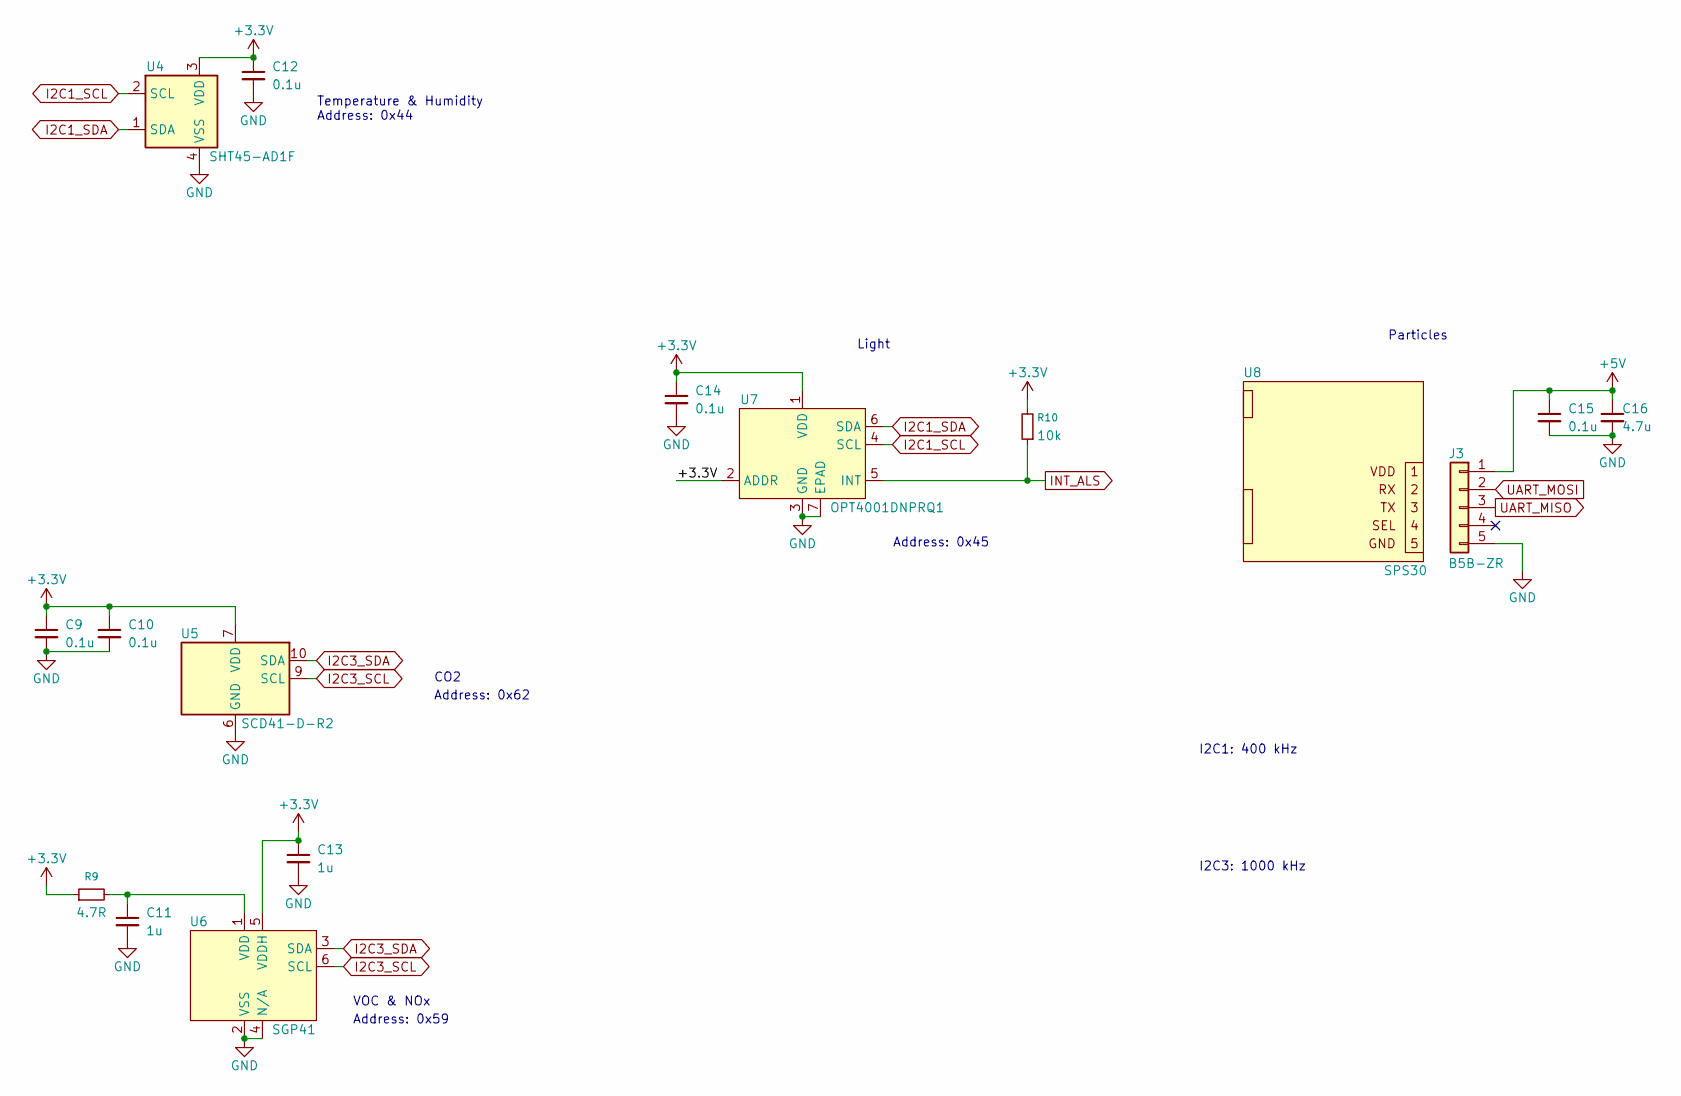
[picture p14: schematic sensors.kicad_sch, Indoor Wireless Sensors]

Parts:
C9, C10, C12, C14, C15: 0.1u; C_0402_1005Metric
C11, C13: 1u; C_0402_1005Metric
C16: 4.7u; C_0805_2012Metric
J3: B5B-ZR; JST_ZH_B5B-ZR_1x05_P1.50mm_Vertical; MPN B5B-ZR(LF)(SN); Mouser PN 306-B5BZRLFSNP
R9: 4.7R; R_0603_1608Metric
R10: 10k; R_0603_1608Metric
U4: SHT45-AD1F; Sensirion_DFN-4_1.5x1.5mm_P0.8mm_SHT4x_NoCentralPad; MPN SHT45-AD1F-R2; Mouser PN 403-SHT45-AD1F-R2
U5: SCD41-D-R2; Sensirion_SCD4x-1EP_10.1x10.1mm_P1.25mm_EP4.8x4.8mm; MPN SCD41-D-R2; Mouser PN 403-SCD41-D-R2
U6: SGP41; Sensirion_DFN-6-1EP_2.44x2.44mm_P0.5mm_EP1.25x1.7mm_SGP4x; MPN SGP41-D-R4; Mouser PN 403-SGP41-D-R4
U7: OPT4001DNPRQ1; TI_USON-6-1EP_2x2mm_P0.5mm_EP0.65x1.35mm; MPN OPT4001DNPRQ1; Mouser PN 595-OPT4001DNPRQ1
U8: SPS30; Sensiron_SPS30; MPN SPS30; Mouser PN 403-SPS30

Connections:
+3.3V: C9.1, C10.1, C12.1, C13.1, C14.1, R9.1, R10.2, U4.3 (VDD), U5.7 (VDD), U5.19 (VDD), U6.5 (VDDH), U7.1 (VDD), U7.2 (ADDR); also elsewhere on the board
+5V: C15.1, C16.1, J3.1; also elsewhere on the board
GND: C9.2, C10.2, C11.2, C12.2, C13.2, C14.2, C15.2, C16.2, J3.5, U4.4 (VSS), U5.6 (GND), U5.20 (GND), U5.21 (GND), U6.2 (VSS), U6.4 (N/A), U7.3 (GND), U7.7 (EPAD); also elsewhere on the board
I2C1_SCL: U4.2 (SCL), U7.4 (SCL); also elsewhere on the board
I2C1_SDA: U4.1 (SDA), U7.6 (SDA); also elsewhere on the board
I2C3_SCL: U5.9 (SCL), U6.6 (SCL); also elsewhere on the board
I2C3_SDA: U5.10 (SDA), U6.3 (SDA); also elsewhere on the board
INT_ALS: R10.1, U7.5 (INT); also elsewhere on the board
unnamed: C11.1, R9.2, U6.1 (VDD)
UART_MISO: J3.3; also elsewhere on the board
UART_MOSI: J3.2; also elsewhere on the board

Notes on the sheet:
Address: 0x59
VOC & NOx
Address: 0x44
Particles
CO2
Light
I2C1: 400 kHz
Address: 0x45
I2C3: 1000 kHz
Temperature & Humidity
Address: 0x62

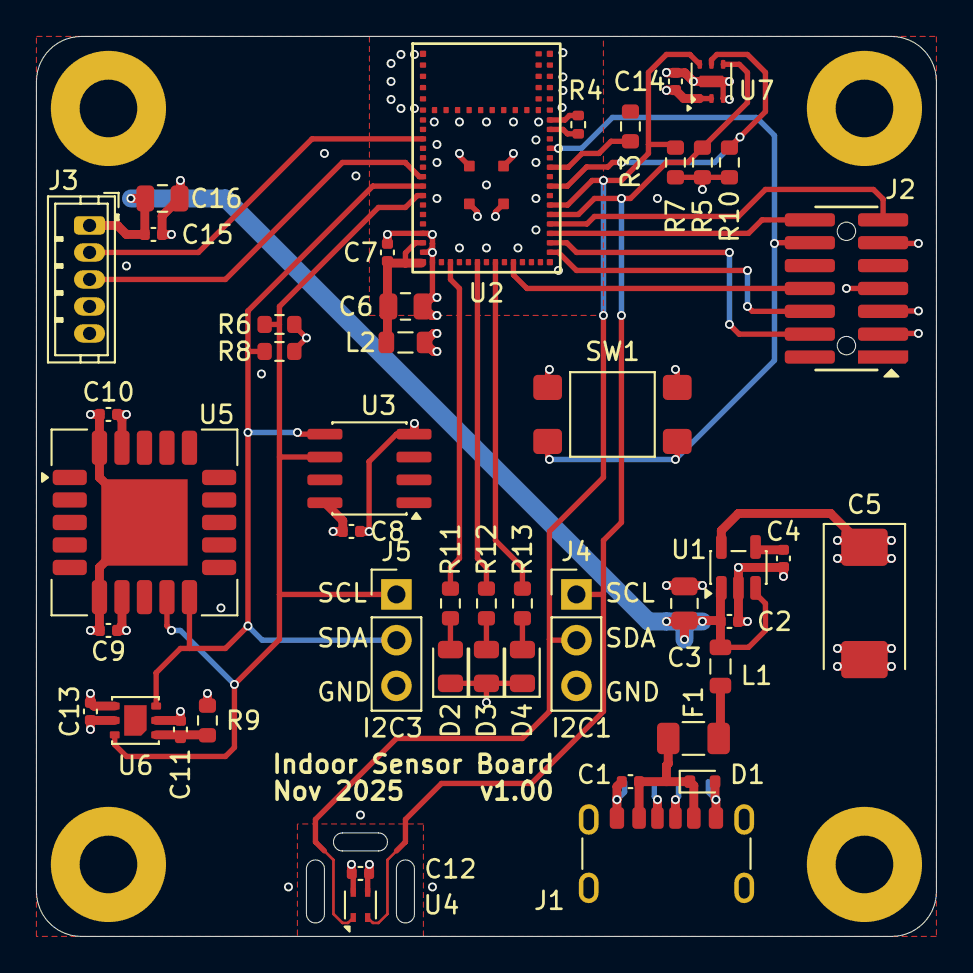
[picture p15: board sensors_indoor.kicad_pcb from above]

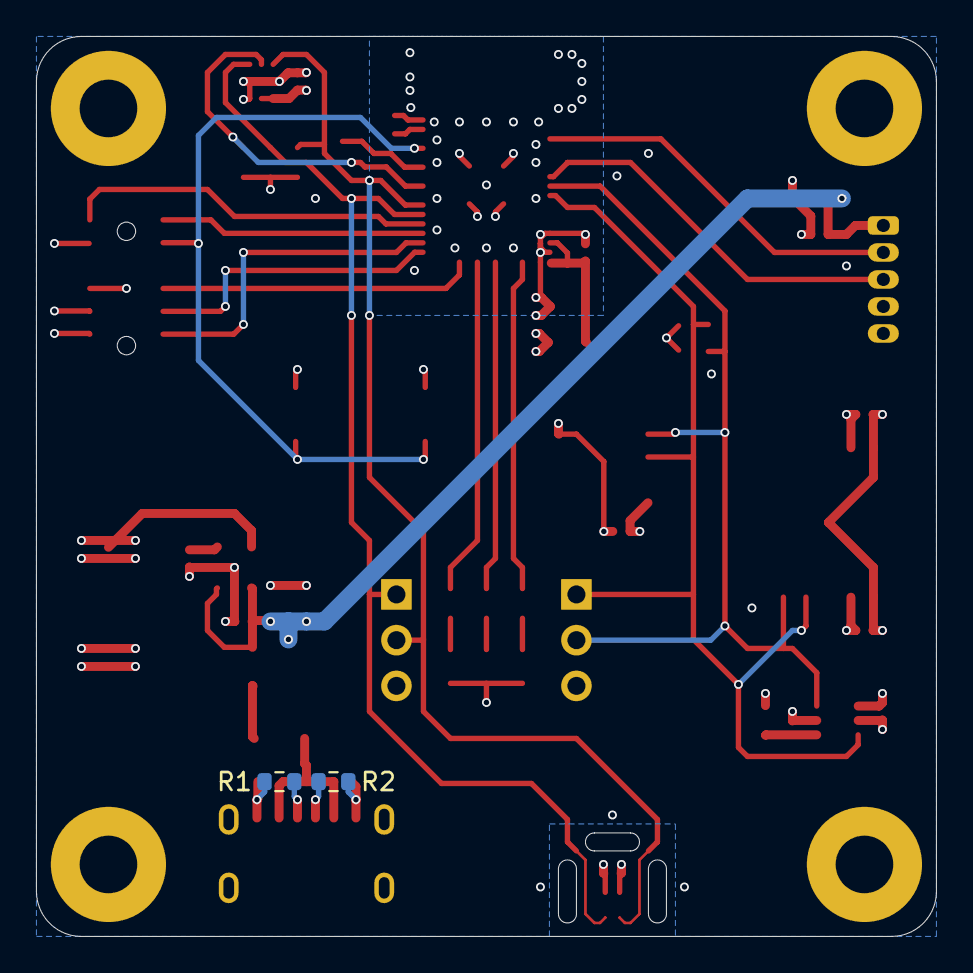
[picture p16: board sensors_indoor.kicad_pcb from below]

Board: 4 copper layers, 50.0 x 50.0 mm, 53 parts (2 on the bottom side), 32 nets.
