dwatman/weather-station/Firmware/display/CM7/Core/Src/main.c

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
/* Includes ------------------------------------------------------------------*/
#include "main.h"
#include "cmsis_os.h"
#include "crc.h"
#include "dma.h"
#include "dma2d.h"
#include "dsihost.h"
#include "jpeg.h"
#include "ltdc.h"
#include "mdma.h"
#include "rng.h"
#include "rtc.h"
#include "gpio.h"
#include "fmc.h"

/* USER CODE BEGIN Includes */
#include "lvgl/lvgl.h"
//#include "lvgl/demos/lv_demos.h"
//#include "lvgl_port_touch.h"
#include "lvgl_port_display.h"

#include "ui.h"
#include "ui_io.h"
#include "shared.h"
/* USER CODE END Includes */

/* USER CODE BEGIN PD */

#ifndef HSEM_ID_0
#define HSEM_ID_0 (0U) /* HW semaphore 0*/
#endif

/* USER CODE END PD */


/* USER CODE BEGIN PV */
osMutexId lvgl_mutex;
volatile uint32_t newdata = 0;
/* USER CODE END PV */

void SystemClock_Config(void);
void PeriphCommonClock_Config(void);
void MX_FREERTOS_Init(void);
/**
  * @brief  The application entry point.
  * @retval int
  */
int main(void)
{

/* USER CODE BEGIN Boot_Mode_Sequence_0 */
  int32_t timeout;
/* USER CODE END Boot_Mode_Sequence_0 */

  /* Enable the CPU Cache */

  /* Enable I-Cache---------------------------------------------------------*/
  SCB_EnableICache();

  /* Enable D-Cache---------------------------------------------------------*/
  SCB_EnableDCache();

/* USER CODE BEGIN Boot_Mode_Sequence_1 */
  /* Wait until CPU2 boots and enters in stop mode or timeout*/
#if 0
  timeout = 0xFFFF;
  while((__HAL_RCC_GET_FLAG(RCC_FLAG_D2CKRDY) != RESET) && (timeout-- > 0));
  if ( timeout < 0 ) {
	  Error_Handler();
  }
#endif
/* USER CODE END Boot_Mode_Sequence_1 */
  /* MCU Configuration--------------------------------------------------------*/

  /* Reset of all peripherals, Initializes the Flash interface and the Systick. */
  HAL_Init();

  /* Configure the system clock */
  SystemClock_Config();

  /* Configure the peripherals common clocks */
  PeriphCommonClock_Config();
/* USER CODE BEGIN Boot_Mode_Sequence_2 */
  /* When system initialization is finished, Cortex-M7 will release Cortex-M4 by means of
  HSEM notification */
  /*HW semaphore Clock enable*/
  __HAL_RCC_HSEM_CLK_ENABLE();
  /*Take HSEM */
  HAL_HSEM_FastTake(HSEM_ID_0);
  /*Release HSEM in order to notify the CPU2(CM4)*/
  HAL_HSEM_Release(HSEM_ID_0,0);
  /* wait until CPU2 wakes up from stop mode */
  timeout = 0xFFFF;
  while((__HAL_RCC_GET_FLAG(RCC_FLAG_D2CKRDY) == RESET) && (timeout-- > 0));
  if ( timeout < 0 ) {
	  Error_Handler();
  }
/* USER CODE END Boot_Mode_Sequence_2 */

  /* Initialize all configured peripherals */
  MX_GPIO_Init();
  MX_MDMA_Init();
  MX_DMA_Init();
  MX_LTDC_Init();
  MX_DMA2D_Init();
  MX_CRC_Init();
  MX_DSIHOST_DSI_Init();
  MX_RNG_Init();
  MX_FMC_Init();
  MX_JPEG_Init();
  MX_RTC_Init();
  /* USER CODE BEGIN 2 */

  // Create mutex to prevent LVGL from getting stuck
  osMutexDef(lvgl_mutex_def);
  lvgl_mutex = osMutexCreate(osMutex(lvgl_mutex_def));
  if (lvgl_mutex == NULL) {
      Error_Handler();
  }

  /* initialize LVGL framework */
  lv_init();
  lv_tick_set_cb(HAL_GetTick);

  /* initialize display */
  lvgl_display_init();

  /* lvgl demo */
  //lv_demo_widgets();
  //lv_demo_music();
  //lv_demo_benchmark();
  ui_init();

  set_time(0x0C12);
  set_t1(-12.3);
  set_t2(45.6);
  set_h1(24.6);
  set_h2(89.0);
  set_press(1234.5);
  set_lux(12345.6);
  set_rssi(-99);

  // Ensure any pending flags are cleared and enable trigger
  __HAL_HSEM_CLEAR_FLAG(__HAL_HSEM_SEMID_TO_MASK(HSEM_ID_1));
  HAL_HSEM_ActivateNotification(__HAL_HSEM_SEMID_TO_MASK(HSEM_ID_1));
  /* USER CODE END 2 */

  /* Call init function for freertos objects (in cmsis_os2.c) */
  MX_FREERTOS_Init();

  /* Start scheduler */
  osKernelStart();

  /* We should never get here as control is now taken by the scheduler */

  /* Infinite loop */
  /* USER CODE BEGIN WHILE */
  while (1)
  {
    /* USER CODE END WHILE */

    /* USER CODE BEGIN 3 */
  }
  /* USER CODE END 3 */
}

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
/* USER CODE BEGIN 4 */
// Triggered from interrupt when M4 has updated shared memory
void HAL_HSEM_FreeCallback(uint32_t SemMask) {
	if (SemMask & __HAL_HSEM_SEMID_TO_MASK(HSEM_ID_1)) 	{
		// Clear flag just in case
		__HAL_HSEM_CLEAR_FLAG(__HAL_HSEM_SEMID_TO_MASK(HSEM_ID_1));
		// Reactivate notification
		HAL_HSEM_ActivateNotification(__HAL_HSEM_SEMID_TO_MASK(HSEM_ID_1));
		newdata = 1;
	}
	//HAL_GPIO_TogglePin(GPIOJ, GPIO_PIN_10); // User LED
}
/* USER CODE END 4 */

/**
  * @brief  Period elapsed callback in non blocking mode
  * @note   This function is called  when TIM2 interrupt took place, inside
  * HAL_TIM_IRQHandler(). It makes a direct call to HAL_IncTick() to increment
  * a global variable "uwTick" used as application time base.
  * @param  htim : TIM handle
  * @retval None
  */
void HAL_TIM_PeriodElapsedCallback(TIM_HandleTypeDef *htim)
{
  if (htim->Instance == TIM2)
  {
    HAL_IncTick();
  }
}

/**
  * @brief  This function is executed in case of error occurrence.
  * @retval None
  */
void Error_Handler(void)
{
  /* USER CODE BEGIN Error_Handler_Debug */
  /* User can add his own implementation to report the HAL error return state */
  __disable_irq();
  while (1)
  {
  }
  /* USER CODE END Error_Handler_Debug */
}
#ifdef USE_FULL_ASSERT
/**
  * @brief  Reports the name of the source file and the source line number
  *         where the assert_param error has occurred.
  * @param  file: pointer to the source file name
  * @param  line: assert_param error line source number
  * @retval None
  */
void assert_failed(uint8_t *file, uint32_t line)
{
  /* USER CODE BEGIN 6 */
  /* User can add his own implementation to report the file name and line number,
     ex: printf("Wrong parameters value: file %s on line %d\r\n", file, line) */
  /* USER CODE END 6 */
}
#endif /* USE_FULL_ASSERT */
