dwatman/weather-station/Firmware/test_temperature/Core/Src/main.c

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
/* Includes ------------------------------------------------------------------*/
#include "main.h"

/* USER CODE BEGIN Includes */
#include "i2c_util.h"
#include "sht40.h"
/* USER CODE END Includes */


COM_InitTypeDef BspCOMInit;

/* USER CODE BEGIN PV */
i2c_t i2c1_info;
sht40_t sht40_device;
/* USER CODE END PV */

void SystemClock_Config(void);
static void MX_GPIO_Init(void);
static void MX_I2C1_Init(void);
static void MX_ICACHE_Init(void);
/**
  * @brief  The application entry point.
  * @retval int
  */
int main(void)
{

  /* MCU Configuration--------------------------------------------------------*/

  /* Reset of all peripherals, Initializes the Flash interface and the Systick. */
  HAL_Init();

  /* Enable PWR clock interface */

  LL_AHB4_GRP1_EnableClock(LL_AHB4_GRP1_PERIPH_PWR);

  /* Configure the system clock */
  SystemClock_Config();

  /* Initialize all configured peripherals */
  MX_GPIO_Init();
  MX_I2C1_Init();
  MX_ICACHE_Init();
  /* Initialize leds */
  BSP_LED_Init(LED_BLUE);
  BSP_LED_Init(LED_GREEN);
  BSP_LED_Init(LED_RED);

  /* Initialize USER push-button, will be used to trigger an interrupt each time it's pressed.*/
  BSP_PB_Init(B1, BUTTON_MODE_EXTI);
  BSP_PB_Init(B2, BUTTON_MODE_EXTI);
  BSP_PB_Init(B3, BUTTON_MODE_EXTI);

  /* Initialize COM1 port (115200, 8 bits (7-bit data + 1 stop bit), no parity */
  BspCOMInit.BaudRate   = 115200;
  BspCOMInit.WordLength = COM_WORDLENGTH_8B;
  BspCOMInit.StopBits   = COM_STOPBITS_1;
  BspCOMInit.Parity     = COM_PARITY_NONE;
  BspCOMInit.HwFlowCtl  = COM_HWCONTROL_NONE;
  if (BSP_COM_Init(COM1, &BspCOMInit) != BSP_ERROR_NONE)
  {
    Error_Handler();
  }

  /* Infinite loop */
  /* USER CODE BEGIN WHILE */
  printf("Start\n");

  i2c_init(&i2c1_info, I2C1);
  sht40_init(&sht40_device, &i2c1_info);
  HAL_Delay(10);
  sht40_reset(&sht40_device);
  HAL_Delay(10);

  uint32_t last_tick = 0;
  while (1)
  {
	uint32_t current_tick = HAL_GetTick();
	if ((current_tick - last_tick) >= 5000) {
		last_tick = current_tick;
		BSP_LED_On(LD1);
		//printf("Write\n");
		sht40_start_measurement(&sht40_device, I2C_SHT40_CMD_MEAS_HI_ACC);
		BSP_LED_Off(LD1);
	}
	if ((sht40_device.i2c->state == I2C_STATE_WRITING) && (sht40_device.timeout == 0)) {
		BSP_LED_On(LD2);
		//printf("Read\n");
		sht40_read_measurement(&sht40_device);
		BSP_LED_Off(LD2);
	}
	if (sht40_device.i2c->done == 1) {
		sht40_device.i2c->done = 0;
		//printf("Done\n");
		sht40_process_measurement(&sht40_device);
	}
	if (sht40_device.new_data == 1) {
		sht40_device.new_data = 0;

		uint32_t temperature = ((21875 * (int32_t)sht40_device.temp_raw) >> 13) - 45000;
		uint32_t humidity = ((15625 * (int32_t)sht40_device.humid_raw) >> 13) - 6000;

		printf("Temperature: %.3f   ", (float)temperature/1000.0f);
		printf("Humidity: %.3f\n", (float)humidity/1000.0f);
	}
    /* USER CODE END WHILE */

    /* USER CODE BEGIN 3 */
  }
  /* USER CODE END 3 */
}

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
