dwatman/weather-station/Firmware/display/STM32CubeIDE/CM7/Application/User/ui/screens.c

#include <string.h>

#include "screens.h"
#include "images.h"
#include "fonts.h"
#include "actions.h"
#include "vars.h"
#include "styles.h"
#include "ui.h"

#include <string.h>

objects_t objects;
lv_obj_t *tick_value_change_obj;
uint32_t active_theme_index = 0;

void create_screen_main() {
    lv_obj_t *obj = lv_obj_create(0);
    objects.main = obj;
    lv_obj_set_pos(obj, 0, 0);
    lv_obj_set_size(obj, 1024, 600);
    lv_obj_set_style_bg_color(obj, lv_color_hex(0xffffffff), LV_PART_MAIN | LV_STATE_DEFAULT);
    {
        lv_obj_t *parent_obj = obj;
        {
            // panel_in
            lv_obj_t *obj = lv_obj_create(parent_obj);
            objects.panel_in = obj;
            lv_obj_set_pos(obj, 15, 130);
            lv_obj_set_size(obj, 360, 280);
            lv_obj_set_style_bg_color(obj, lv_color_hex(0xffdcf0ff), LV_PART_MAIN | LV_STATE_DEFAULT);
            lv_obj_set_style_border_color(obj, lv_color_hex(0xffabd9fb), LV_PART_MAIN | LV_STATE_DEFAULT);
            lv_obj_set_style_radius(obj, 30, LV_PART_MAIN | LV_STATE_DEFAULT);
            lv_obj_set_style_border_width(obj, 3, LV_PART_MAIN | LV_STATE_DEFAULT);
        }
        {
            // panel_out
            lv_obj_t *obj = lv_obj_create(parent_obj);
            objects.panel_out = obj;
            lv_obj_set_pos(obj, 405, 130);
            lv_obj_set_size(obj, 360, 280);
            lv_obj_set_style_bg_color(obj, lv_color_hex(0xffdcffe9), LV_PART_MAIN | LV_STATE_DEFAULT);
            lv_obj_set_style_border_color(obj, lv_color_hex(0xffb5ffd1), LV_PART_MAIN | LV_STATE_DEFAULT);
            lv_obj_set_style_radius(obj, 30, LV_PART_MAIN | LV_STATE_DEFAULT);
            lv_obj_set_style_border_width(obj, 3, LV_PART_MAIN | LV_STATE_DEFAULT);
        }
        {
            // panel_press
            lv_obj_t *obj = lv_obj_create(parent_obj);
            objects.panel_press = obj;
            lv_obj_set_pos(obj, 142, 441);
            lv_obj_set_size(obj, 502, 129);
            lv_obj_set_style_bg_color(obj, lv_color_hex(0xfff0f0f0), LV_PART_MAIN | LV_STATE_DEFAULT);
            lv_obj_set_style_border_color(obj, lv_color_hex(0xffdcdcdc), LV_PART_MAIN | LV_STATE_DEFAULT);
            lv_obj_set_style_radius(obj, 30, LV_PART_MAIN | LV_STATE_DEFAULT);
            lv_obj_set_style_border_width(obj, 3, LV_PART_MAIN | LV_STATE_DEFAULT);
        }
        {
            lv_obj_t *obj = lv_scale_create(parent_obj);
            lv_obj_set_pos(obj, 984, 130);
            lv_obj_set_size(obj, 40, 400);
            lv_scale_set_mode(obj, LV_SCALE_MODE_VERTICAL_RIGHT);
            lv_scale_set_range(obj, 0, 100);
            lv_scale_set_total_tick_count(obj, 21);
            lv_scale_set_major_tick_every(obj, 2);
            lv_scale_set_label_show(obj, true);
            lv_obj_set_style_length(obj, 5, LV_PART_ITEMS | LV_STATE_DEFAULT);
            lv_obj_set_style_line_width(obj, 1, LV_PART_ITEMS | LV_STATE_DEFAULT);
            lv_obj_set_style_length(obj, 10, LV_PART_INDICATOR | LV_STATE_DEFAULT);
            lv_obj_set_style_line_width(obj, 1, LV_PART_INDICATOR | LV_STATE_DEFAULT);
        }
        {
            // indoor_temp
            lv_obj_t *obj = lv_label_create(parent_obj);
            objects.indoor_temp = obj;
            lv_obj_set_pos(obj, 10, 185);
            lv_obj_set_size(obj, 290, LV_SIZE_CONTENT);
            lv_label_set_long_mode(obj, LV_LABEL_LONG_CLIP);
            lv_obj_set_style_text_font(obj, &ui_font_open_sans_120, LV_PART_MAIN | LV_STATE_DEFAULT);
            lv_obj_set_style_text_align(obj, LV_TEXT_ALIGN_RIGHT, LV_PART_MAIN | LV_STATE_DEFAULT);
            lv_label_set_text(obj, "");
        }
        {
            // indoor_humidity
            lv_obj_t *obj = lv_label_create(parent_obj);
            objects.indoor_humidity = obj;
            lv_obj_set_pos(obj, 50, 300);
            lv_obj_set_size(obj, 250, LV_SIZE_CONTENT);
            lv_label_set_long_mode(obj, LV_LABEL_LONG_CLIP);
            lv_obj_set_style_text_font(obj, &ui_font_open_sans_120, LV_PART_MAIN | LV_STATE_DEFAULT);
            lv_obj_set_style_text_align(obj, LV_TEXT_ALIGN_RIGHT, LV_PART_MAIN | LV_STATE_DEFAULT);
            lv_label_set_text(obj, "");
        }
        {
            lv_obj_t *obj = lv_label_create(parent_obj);
            lv_obj_set_pos(obj, 300, 185);
            lv_obj_set_size(obj, LV_SIZE_CONTENT, LV_SIZE_CONTENT);
            lv_label_set_long_mode(obj, LV_LABEL_LONG_CLIP);
            lv_obj_set_style_text_font(obj, &lv_font_montserrat_48, LV_PART_MAIN | LV_STATE_DEFAULT);
            lv_obj_set_style_text_align(obj, LV_TEXT_ALIGN_LEFT, LV_PART_MAIN | LV_STATE_DEFAULT);
            lv_label_set_text(obj, "°C");
        }
        {
            lv_obj_t *obj = lv_label_create(parent_obj);
            lv_obj_set_pos(obj, 309, 320);
            lv_obj_set_size(obj, LV_SIZE_CONTENT, LV_SIZE_CONTENT);
            lv_label_set_long_mode(obj, LV_LABEL_LONG_CLIP);
            lv_obj_set_style_text_font(obj, &lv_font_montserrat_48, LV_PART_MAIN | LV_STATE_DEFAULT);
            lv_obj_set_style_text_align(obj, LV_TEXT_ALIGN_LEFT, LV_PART_MAIN | LV_STATE_DEFAULT);
            lv_label_set_text(obj, "%");
        }
        {
            // outdoor_temp
            lv_obj_t *obj = lv_label_create(parent_obj);
            objects.outdoor_temp = obj;
            lv_obj_set_pos(obj, 400, 185);
            lv_obj_set_size(obj, 290, LV_SIZE_CONTENT);
            lv_label_set_long_mode(obj, LV_LABEL_LONG_CLIP);
            lv_obj_set_style_text_font(obj, &ui_font_open_sans_120, LV_PART_MAIN | LV_STATE_DEFAULT);
            lv_obj_set_style_text_align(obj, LV_TEXT_ALIGN_RIGHT, LV_PART_MAIN | LV_STATE_DEFAULT);
            lv_label_set_text(obj, "");
        }
        {
            // outdoor_humidity
            lv_obj_t *obj = lv_label_create(parent_obj);
            objects.outdoor_humidity = obj;
            lv_obj_set_pos(obj, 440, 300);
            lv_obj_set_size(obj, 250, LV_SIZE_CONTENT);
            lv_label_set_long_mode(obj, LV_LABEL_LONG_CLIP);
            lv_obj_set_style_text_font(obj, &ui_font_open_sans_120, LV_PART_MAIN | LV_STATE_DEFAULT);
            lv_obj_set_style_text_align(obj, LV_TEXT_ALIGN_RIGHT, LV_PART_MAIN | LV_STATE_DEFAULT);
            lv_label_set_text(obj, "");
        }
        {
            lv_obj_t *obj = lv_label_create(parent_obj);
            lv_obj_set_pos(obj, 690, 185);
            lv_obj_set_size(obj, LV_SIZE_CONTENT, LV_SIZE_CONTENT);
            lv_label_set_long_mode(obj, LV_LABEL_LONG_CLIP);
            lv_obj_set_style_text_font(obj, &lv_font_montserrat_48, LV_PART_MAIN | LV_STATE_DEFAULT);
            lv_obj_set_style_text_align(obj, LV_TEXT_ALIGN_LEFT, LV_PART_MAIN | LV_STATE_DEFAULT);
            lv_label_set_text(obj, "°C");
        }
        {
            lv_obj_t *obj = lv_label_create(parent_obj);
            lv_obj_set_pos(obj, 699, 320);
            lv_obj_set_size(obj, LV_SIZE_CONTENT, LV_SIZE_CONTENT);
            lv_label_set_long_mode(obj, LV_LABEL_LONG_CLIP);
            lv_obj_set_style_text_font(obj, &lv_font_montserrat_48, LV_PART_MAIN | LV_STATE_DEFAULT);
            lv_obj_set_style_text_align(obj, LV_TEXT_ALIGN_LEFT, LV_PART_MAIN | LV_STATE_DEFAULT);
            lv_label_set_text(obj, "%");
        }
        {
            // indoor_lux
            lv_obj_t *obj = lv_label_create(parent_obj);
            objects.indoor_lux = obj;
            lv_obj_set_pos(obj, 737, 573);
            lv_obj_set_size(obj, 120, LV_SIZE_CONTENT);
            lv_label_set_long_mode(obj, LV_LABEL_LONG_CLIP);
            lv_obj_set_style_text_font(obj, &lv_font_montserrat_24, LV_PART_MAIN | LV_STATE_DEFAULT);
            lv_obj_set_style_text_align(obj, LV_TEXT_ALIGN_RIGHT, LV_PART_MAIN | LV_STATE_DEFAULT);
            lv_label_set_text(obj, "");
        }
        {
            lv_obj_t *obj = lv_label_create(parent_obj);
            lv_obj_set_pos(obj, 866, 573);
            lv_obj_set_size(obj, LV_SIZE_CONTENT, LV_SIZE_CONTENT);
            lv_label_set_long_mode(obj, LV_LABEL_LONG_CLIP);
            lv_obj_set_style_text_font(obj, &lv_font_montserrat_24, LV_PART_MAIN | LV_STATE_DEFAULT);
            lv_obj_set_style_text_align(obj, LV_TEXT_ALIGN_LEFT, LV_PART_MAIN | LV_STATE_DEFAULT);
            lv_label_set_text(obj, "lux");
        }
        {
            // wifi_dbm
            lv_obj_t *obj = lv_label_create(parent_obj);
            objects.wifi_dbm = obj;
            lv_obj_set_pos(obj, 854, 10);
            lv_obj_set_size(obj, 50, LV_SIZE_CONTENT);
            lv_label_set_long_mode(obj, LV_LABEL_LONG_CLIP);
            lv_obj_set_style_text_align(obj, LV_TEXT_ALIGN_RIGHT, LV_PART_MAIN | LV_STATE_DEFAULT);
            lv_obj_set_style_text_font(obj, &lv_font_montserrat_24, LV_PART_MAIN | LV_STATE_DEFAULT);
            lv_label_set_text(obj, "");
        }
        {
            lv_obj_t *obj = lv_label_create(parent_obj);
            lv_obj_set_pos(obj, 910, 10);
            lv_obj_set_size(obj, LV_SIZE_CONTENT, LV_SIZE_CONTENT);
            lv_label_set_long_mode(obj, LV_LABEL_LONG_CLIP);
            lv_obj_set_style_text_font(obj, &lv_font_montserrat_24, LV_PART_MAIN | LV_STATE_DEFAULT);
            lv_obj_set_style_text_align(obj, LV_TEXT_ALIGN_LEFT, LV_PART_MAIN | LV_STATE_DEFAULT);
            lv_label_set_text(obj, "dBm");
        }
        {
            // img_wifi
            lv_obj_t *obj = lv_image_create(parent_obj);
            objects.img_wifi = obj;
            lv_obj_set_pos(obj, 972, 2);
            lv_obj_set_size(obj, LV_SIZE_CONTENT, LV_SIZE_CONTENT);
            lv_image_set_src(obj, &img_img_wifi);
            lv_image_set_inner_align(obj, LV_IMAGE_ALIGN_DEFAULT);
            lv_obj_set_style_image_recolor(obj, lv_color_hex(0xffff0000), LV_PART_MAIN | LV_STATE_DEFAULT);
            lv_obj_set_style_image_recolor_opa(obj, 255, LV_PART_MAIN | LV_STATE_DEFAULT);
        }
        {
            // clock
            lv_obj_t *obj = lv_label_create(parent_obj);
            objects.clock = obj;
            lv_obj_set_pos(obj, 0, 12);
            lv_obj_set_size(obj, 320, LV_SIZE_CONTENT);
            lv_label_set_long_mode(obj, LV_LABEL_LONG_CLIP);
            lv_obj_set_style_text_font(obj, &ui_font_open_sans_120, LV_PART_MAIN | LV_STATE_DEFAULT);
            lv_obj_set_style_text_align(obj, LV_TEXT_ALIGN_RIGHT, LV_PART_MAIN | LV_STATE_DEFAULT);
            lv_label_set_text(obj, "");
        }
        {
            lv_obj_t *obj = lv_label_create(parent_obj);
            objects.obj0 = obj;
            lv_obj_set_pos(obj, 331, 57);
            lv_obj_set_size(obj, LV_SIZE_CONTENT, LV_SIZE_CONTENT);
            lv_label_set_long_mode(obj, LV_LABEL_LONG_CLIP);
            lv_obj_set_style_text_font(obj, &lv_font_montserrat_48, LV_PART_MAIN | LV_STATE_DEFAULT);
            lv_obj_set_style_text_align(obj, LV_TEXT_ALIGN_LEFT, LV_PART_MAIN | LV_STATE_DEFAULT);
            lv_label_set_text(obj, "");
        }
        {
            // indoor_pressure
            lv_obj_t *obj = lv_label_create(parent_obj);
            objects.indoor_pressure = obj;
            lv_obj_set_pos(obj, 135, 460);
            lv_obj_set_size(obj, 390, LV_SIZE_CONTENT);
            lv_label_set_long_mode(obj, LV_LABEL_LONG_CLIP);
            lv_obj_set_style_text_font(obj, &ui_font_open_sans_120, LV_PART_MAIN | LV_STATE_DEFAULT);
            lv_obj_set_style_text_align(obj, LV_TEXT_ALIGN_RIGHT, LV_PART_MAIN | LV_STATE_DEFAULT);
            lv_label_set_text(obj, "");
        }
        {
            lv_obj_t *obj = lv_label_create(parent_obj);
            lv_obj_set_pos(obj, 532, 495);
            lv_obj_set_size(obj, LV_SIZE_CONTENT, LV_SIZE_CONTENT);
            lv_label_set_long_mode(obj, LV_LABEL_LONG_CLIP);
            lv_obj_set_style_text_font(obj, &lv_font_montserrat_48, LV_PART_MAIN | LV_STATE_DEFAULT);
            lv_obj_set_style_text_align(obj, LV_TEXT_ALIGN_LEFT, LV_PART_MAIN | LV_STATE_DEFAULT);
            lv_label_set_text(obj, "hPa");
        }
        {
            lv_obj_t *obj = lv_label_create(parent_obj);
            lv_obj_set_pos(obj, 142, 135);
            lv_obj_set_size(obj, LV_SIZE_CONTENT, LV_SIZE_CONTENT);
            lv_label_set_long_mode(obj, LV_LABEL_LONG_CLIP);
            lv_obj_set_style_text_font(obj, &lv_font_montserrat_32, LV_PART_MAIN | LV_STATE_DEFAULT);
            lv_obj_set_style_text_align(obj, LV_TEXT_ALIGN_LEFT, LV_PART_MAIN | LV_STATE_DEFAULT);
            lv_label_set_text(obj, "Indoor");
        }
        {
            lv_obj_t *obj = lv_label_create(parent_obj);
            lv_obj_set_pos(obj, 517, 135);
            lv_obj_set_size(obj, LV_SIZE_CONTENT, LV_SIZE_CONTENT);
            lv_label_set_long_mode(obj, LV_LABEL_LONG_CLIP);
            lv_obj_set_style_text_font(obj, &lv_font_montserrat_32, LV_PART_MAIN | LV_STATE_DEFAULT);
            lv_obj_set_style_text_align(obj, LV_TEXT_ALIGN_LEFT, LV_PART_MAIN | LV_STATE_DEFAULT);
            lv_label_set_text(obj, "Outdoor");
        }
        {
            // bar1
            lv_obj_t *obj = lv_bar_create(parent_obj);
            objects.bar1 = obj;
            lv_obj_set_pos(obj, 804, 130);
            lv_obj_set_size(obj, 25, 400);
            lv_obj_set_style_bg_grad_dir(obj, LV_GRAD_DIR_VER, LV_PART_INDICATOR | LV_STATE_DEFAULT);
            lv_obj_set_style_bg_grad_color(obj, lv_color_hex(0xffff0000), LV_PART_INDICATOR | LV_STATE_DEFAULT);
            lv_obj_set_style_bg_color(obj, lv_color_hex(0xff00ff00), LV_PART_INDICATOR | LV_STATE_DEFAULT);
            lv_obj_set_style_radius(obj, 10, LV_PART_INDICATOR | LV_STATE_DEFAULT);
            lv_obj_set_style_bg_main_stop(obj, 20, LV_PART_INDICATOR | LV_STATE_DEFAULT);
            lv_obj_set_style_radius(obj, 10, LV_PART_MAIN | LV_STATE_DEFAULT);
            lv_obj_set_style_bg_color(obj, lv_color_hex(0xffd0d0d0), LV_PART_MAIN | LV_STATE_DEFAULT);
        }
        {
            // bar2
            lv_obj_t *obj = lv_bar_create(parent_obj);
            objects.bar2 = obj;
            lv_obj_set_pos(obj, 834, 130);
            lv_obj_set_size(obj, 25, 400);
            lv_obj_set_style_bg_grad_dir(obj, LV_GRAD_DIR_VER, LV_PART_INDICATOR | LV_STATE_DEFAULT);
            lv_obj_set_style_bg_grad_color(obj, lv_color_hex(0xffff0000), LV_PART_INDICATOR | LV_STATE_DEFAULT);
            lv_obj_set_style_bg_color(obj, lv_color_hex(0xff00ff00), LV_PART_INDICATOR | LV_STATE_DEFAULT);
            lv_obj_set_style_radius(obj, 10, LV_PART_INDICATOR | LV_STATE_DEFAULT);
            lv_obj_set_style_bg_main_stop(obj, 20, LV_PART_INDICATOR | LV_STATE_DEFAULT);
            lv_obj_set_style_radius(obj, 10, LV_PART_MAIN | LV_STATE_DEFAULT);
            lv_obj_set_style_bg_color(obj, lv_color_hex(0xffd0d0d0), LV_PART_MAIN | LV_STATE_DEFAULT);
        }
        {
            // bar3
            lv_obj_t *obj = lv_bar_create(parent_obj);
            objects.bar3 = obj;
            lv_obj_set_pos(obj, 864, 130);
            lv_obj_set_size(obj, 25, 400);
            lv_obj_set_style_bg_grad_dir(obj, LV_GRAD_DIR_VER, LV_PART_INDICATOR | LV_STATE_DEFAULT);
            lv_obj_set_style_bg_grad_color(obj, lv_color_hex(0xffff0000), LV_PART_INDICATOR | LV_STATE_DEFAULT);
            lv_obj_set_style_bg_color(obj, lv_color_hex(0xff00ff00), LV_PART_INDICATOR | LV_STATE_DEFAULT);
            lv_obj_set_style_radius(obj, 10, LV_PART_INDICATOR | LV_STATE_DEFAULT);
            lv_obj_set_style_bg_main_stop(obj, 20, LV_PART_INDICATOR | LV_STATE_DEFAULT);
            lv_obj_set_style_radius(obj, 10, LV_PART_MAIN | LV_STATE_DEFAULT);
            lv_obj_set_style_bg_color(obj, lv_color_hex(0xffd0d0d0), LV_PART_MAIN | LV_STATE_DEFAULT);
        }
        {
            // bar4
            lv_obj_t *obj = lv_bar_create(parent_obj);
            objects.bar4 = obj;
            lv_obj_set_pos(obj, 894, 130);
            lv_obj_set_size(obj, 25, 400);
            lv_obj_set_style_bg_grad_dir(obj, LV_GRAD_DIR_VER, LV_PART_INDICATOR | LV_STATE_DEFAULT);
            lv_obj_set_style_bg_grad_color(obj, lv_color_hex(0xffff0000), LV_PART_INDICATOR | LV_STATE_DEFAULT);
            lv_obj_set_style_bg_color(obj, lv_color_hex(0xff00ff00), LV_PART_INDICATOR | LV_STATE_DEFAULT);
            lv_obj_set_style_radius(obj, 10, LV_PART_INDICATOR | LV_STATE_DEFAULT);
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
            lv_obj_set_size(obj, LV_SIZE_CONTENT, LV_SIZE_CONTENT);
            lv_label_set_long_mode(obj, LV_LABEL_LONG_CLIP);
            lv_obj_set_style_text_font(obj, &lv_font_montserrat_14, LV_PART_MAIN | LV_STATE_DEFAULT);
            lv_label_set_text(obj, "5");
        }
        {
            lv_obj_t *obj = lv_label_create(parent_obj);
            lv_obj_set_pos(obj, 962, 112);
            lv_obj_set_size(obj, LV_SIZE_CONTENT, LV_SIZE_CONTENT);
            lv_label_set_long_mode(obj, LV_LABEL_LONG_CLIP);
            lv_obj_set_style_text_font(obj, &lv_font_montserrat_14, LV_PART_MAIN | LV_STATE_DEFAULT);
            lv_label_set_text(obj, "6");
        }
        {
            // display_bl
            lv_obj_t *obj = lv_label_create(parent_obj);
            objects.display_bl = obj;
            lv_obj_set_pos(obj, 916, 573);
            lv_obj_set_size(obj, 65, LV_SIZE_CONTENT);
            lv_label_set_long_mode(obj, LV_LABEL_LONG_CLIP);
            lv_obj_set_style_text_font(obj, &lv_font_montserrat_24, LV_PART_MAIN | LV_STATE_DEFAULT);
            lv_obj_set_style_text_align(obj, LV_TEXT_ALIGN_RIGHT, LV_PART_MAIN | LV_STATE_DEFAULT);
            lv_label_set_text(obj, "");
        }
        {
            lv_obj_t *obj = lv_label_create(parent_obj);
            lv_obj_set_pos(obj, 987, 573);
            lv_obj_set_size(obj, LV_SIZE_CONTENT, LV_SIZE_CONTENT);
            lv_label_set_long_mode(obj, LV_LABEL_LONG_CLIP);
            lv_obj_set_style_text_font(obj, &lv_font_montserrat_24, LV_PART_MAIN | LV_STATE_DEFAULT);
            lv_obj_set_style_text_align(obj, LV_TEXT_ALIGN_LEFT, LV_PART_MAIN | LV_STATE_DEFAULT);
            lv_label_set_text(obj, "BL");
        }
        {
            lv_obj_t *obj = lv_label_create(parent_obj);
            lv_obj_set_pos(obj, 526, 84);
            lv_obj_set_size(obj, LV_SIZE_CONTENT, LV_SIZE_CONTENT);
            lv_label_set_long_mode(obj, LV_LABEL_LONG_CLIP);
            lv_obj_set_style_text_font(obj, &lv_font_montserrat_32, LV_PART_MAIN | LV_STATE_DEFAULT);
            lv_obj_set_style_text_align(obj, LV_TEXT_ALIGN_LEFT, LV_PART_MAIN | LV_STATE_DEFAULT);
            lv_label_set_text(obj, "Garage");
        }
        {
            lv_obj_t *obj = lv_image_create(parent_obj);
            lv_obj_set_pos(obj, 535, 7);
            lv_obj_set_size(obj, LV_SIZE_CONTENT, LV_SIZE_CONTENT);
            lv_image_set_src(obj, &img_garage);
        }
        {
            // garage_door
            lv_obj_t *obj = lv_obj_create(parent_obj);
            objects.garage_door = obj;
            lv_obj_set_pos(obj, 553, 40);
            lv_obj_set_size(obj, 64, 44);
            lv_obj_set_style_bg_color(obj, lv_color_hex(0xffff0000), LV_PART_MAIN | LV_STATE_DEFAULT);
            lv_obj_set_style_border_width(obj, 0, LV_PART_MAIN | LV_STATE_DEFAULT);
            lv_obj_set_style_radius(obj, 0, LV_PART_MAIN | LV_STATE_DEFAULT);
            lv_obj_set_style_opa(obj, 127, LV_PART_MAIN | LV_STATE_DEFAULT);
            lv_obj_set_style_bg_opa(obj, 0, LV_PART_SCROLLBAR | LV_STATE_DEFAULT);
        }
    }
    
    tick_screen_main();
}

void tick_screen_main() {
    {
        const char *new_val = get_var_t1_str();
        const char *cur_val = lv_label_get_text(objects.indoor_temp);
        if (strcmp(new_val, cur_val) != 0) {
            tick_value_change_obj = objects.indoor_temp;
            lv_label_set_text(objects.indoor_temp, new_val);
            tick_value_change_obj = NULL;
        }
    }
    {
        const char *new_val = get_var_h1_str();
        const char *cur_val = lv_label_get_text(objects.indoor_humidity);
        if (strcmp(new_val, cur_val) != 0) {
            tick_value_change_obj = objects.indoor_humidity;
            lv_label_set_text(objects.indoor_humidity, new_val);
            tick_value_change_obj = NULL;
        }
    }
    {
        const char *new_val = get_var_t2_str();
        const char *cur_val = lv_label_get_text(objects.outdoor_temp);
        if (strcmp(new_val, cur_val) != 0) {
            tick_value_change_obj = objects.outdoor_temp;
            lv_label_set_text(objects.outdoor_temp, new_val);
            tick_value_change_obj = NULL;
        }
    }
    {
        const char *new_val = get_var_h2_str();
        const char *cur_val = lv_label_get_text(objects.outdoor_humidity);
        if (strcmp(new_val, cur_val) != 0) {
            tick_value_change_obj = objects.outdoor_humidity;
            lv_label_set_text(objects.outdoor_humidity, new_val);
            tick_value_change_obj = NULL;
        }
    }
    {
        const char *new_val = get_var_lux_str();
        const char *cur_val = lv_label_get_text(objects.indoor_lux);
        if (strcmp(new_val, cur_val) != 0) {
            tick_value_change_obj = objects.indoor_lux;
            lv_label_set_text(objects.indoor_lux, new_val);
            tick_value_change_obj = NULL;
        }
    }
    {
        const char *new_val = get_var_rssi_str();
        const char *cur_val = lv_label_get_text(objects.wifi_dbm);
        if (strcmp(new_val, cur_val) != 0) {
            tick_value_change_obj = objects.wifi_dbm;
            lv_label_set_text(objects.wifi_dbm, new_val);
            tick_value_change_obj = NULL;
        }
    }
    {
        const char *new_val = get_var_time_str();
        const char *cur_val = lv_label_get_text(objects.clock);
        if (strcmp(new_val, cur_val) != 0) {
            tick_value_change_obj = objects.clock;
            lv_label_set_text(objects.clock, new_val);
            tick_value_change_obj = NULL;
        }
    }
    {
        const char *new_val = get_var_ampm_str();
        const char *cur_val = lv_label_get_text(objects.obj0);
        if (strcmp(new_val, cur_val) != 0) {
            tick_value_change_obj = objects.obj0;
            lv_label_set_text(objects.obj0, new_val);
            tick_value_change_obj = NULL;
        }
    }
    {
        const char *new_val = get_var_press_str();
        const char *cur_val = lv_label_get_text(objects.indoor_pressure);
        if (strcmp(new_val, cur_val) != 0) {
            tick_value_change_obj = objects.indoor_pressure;
            lv_label_set_text(objects.indoor_pressure, new_val);
            tick_value_change_obj = NULL;
        }
    }
    {
        int32_t new_val = get_var_soil1_int();
        int32_t cur_val = lv_bar_get_value(objects.bar1);
        if (new_val != cur_val) {
            tick_value_change_obj = objects.bar1;
            lv_bar_set_value(objects.bar1, new_val, LV_ANIM_OFF);
            tick_value_change_obj = NULL;
        }
    }
    {
        int32_t new_val = get_var_soil2_int();
        int32_t cur_val = lv_bar_get_value(objects.bar2);
        if (new_val != cur_val) {
            tick_value_change_obj = objects.bar2;
            lv_bar_set_value(objects.bar2, new_val, LV_ANIM_OFF);
            tick_value_change_obj = NULL;
        }
    }
    {
        int32_t new_val = get_var_soil3_int();
        int32_t cur_val = lv_bar_get_value(objects.bar3);
        if (new_val != cur_val) {
            tick_value_change_obj = objects.bar3;
            lv_bar_set_value(objects.bar3, new_val, LV_ANIM_OFF);
            tick_value_change_obj = NULL;
        }
    }
    {
        int32_t new_val = get_var_soil4_int();
        int32_t cur_val = lv_bar_get_value(objects.bar4);
        if (new_val != cur_val) {
            tick_value_change_obj = objects.bar4;
            lv_bar_set_value(objects.bar4, new_val, LV_ANIM_OFF);
            tick_value_change_obj = NULL;
        }
    }
    {
        int32_t new_val = get_var_soil5_int();
        int32_t cur_val = lv_bar_get_value(objects.bar5);
        if (new_val != cur_val) {
            tick_value_change_obj = objects.bar5;
            lv_bar_set_value(objects.bar5, new_val, LV_ANIM_OFF);
            tick_value_change_obj = NULL;
        }
    }
    {
        int32_t new_val = get_var_soil6_int();
        int32_t cur_val = lv_bar_get_value(objects.bar6);
        if (new_val != cur_val) {
            tick_value_change_obj = objects.bar6;
            lv_bar_set_value(objects.bar6, new_val, LV_ANIM_OFF);
            tick_value_change_obj = NULL;
        }
    }
    {
        const char *new_val = get_var_bl_str();
        const char *cur_val = lv_label_get_text(objects.display_bl);
        if (strcmp(new_val, cur_val) != 0) {
            tick_value_change_obj = objects.display_bl;
            lv_label_set_text(objects.display_bl, new_val);
            tick_value_change_obj = NULL;
        }
    }
}



typedef void (*tick_screen_func_t)();
tick_screen_func_t tick_screen_funcs[] = {
    tick_screen_main,
};
void tick_screen(int screen_index) {
    tick_screen_funcs[screen_index]();
}
void tick_screen_by_id(enum ScreensEnum screenId) {
    tick_screen_funcs[screenId - 1]();
}

void create_screens() {
    lv_disp_t *dispp = lv_disp_get_default();
    lv_theme_t *theme = lv_theme_default_init(dispp, lv_palette_main(LV_PALETTE_BLUE), lv_palette_main(LV_PALETTE_RED), false, LV_FONT_DEFAULT);
    lv_disp_set_theme(dispp, theme);
    
    create_screen_main();
}
