dwatman/weather-station/Firmware/test_particle/Sensiron/sensirion_shdlc.h

/*
 * Copyright (c) 2018, Sensirion AG
 * All rights reserved.
 *
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
 * * Neither the name of Sensirion AG nor the names of its
 *   contributors may be used to endorse or promote products derived from
 *   this software without specific prior written permission.
 *
 * THIS SOFTWARE IS PROVIDED BY THE COPYRIGHT HOLDERS AND CONTRIBUTORS "AS IS"
 * AND ANY EXPRESS OR IMPLIED WARRANTIES, INCLUDING, BUT NOT LIMITED TO, THE
 * IMPLIED WARRANTIES OF MERCHANTABILITY AND FITNESS FOR A PARTICULAR PURPOSE
 * ARE DISCLAIMED. IN NO EVENT SHALL THE COPYRIGHT HOLDER OR CONTRIBUTORS BE
 * LIABLE FOR ANY DIRECT, INDIRECT, INCIDENTAL, SPECIAL, EXEMPLARY, OR
 * CONSEQUENTIAL DAMAGES (INCLUDING, BUT NOT LIMITED TO, PROCUREMENT OF
 * SUBSTITUTE GOODS OR SERVICES; LOSS OF USE, DATA, OR PROFITS; OR BUSINESS
 * INTERRUPTION) HOWEVER CAUSED AND ON ANY THEORY OF LIABILITY, WHETHER IN
 * CONTRACT, STRICT LIABILITY, OR TORT (INCLUDING NEGLIGENCE OR OTHERWISE)
 * ARISING IN ANY WAY OUT OF THE USE OF THIS SOFTWARE, EVEN IF ADVISED OF THE
 * POSSIBILITY OF SUCH DAMAGE.
 */
// NOTE: Heavily modified

#ifndef SENSIRION_SHDLC_H
#define SENSIRION_SHDLC_H

#include <stdint.h>
#include <stdbool.h>

#include "usart_dma.h"

#ifdef __cplusplus
extern "C" {
#endif

#define SENSIRION_SHDLC_ERR_NO_DATA -1
#define SENSIRION_SHDLC_ERR_MISSING_START -2
#define SENSIRION_SHDLC_ERR_MISSING_STOP -3
#define SENSIRION_SHDLC_ERR_CRC_MISMATCH -4
#define SENSIRION_SHDLC_ERR_ENCODING_ERROR -5
#define SENSIRION_SHDLC_ERR_TX_INCOMPLETE -6
#define SENSIRION_SHDLC_ERR_FRAME_TOO_LONG -7
#define SENSIRION_SHDLC_ERR_EXECUTION_FAILURE -8

#define SHDLC_START 0x7E
#define SHDLC_STOP 0x7E

#define SHDLC_MIN_TX_FRAME_SIZE 6 // start + header(3) + crc + stop
#define SHDLC_MIN_RX_FRAME_SIZE 7 // start + header(4) + crc + stop

// start/stop + (4 header + 255 data) * 2 because of byte stuffing
#define SHDLC_FRAME_MAX_TX_FRAME_SIZE (2 + (4 + 255) * 2)

// start/stop + (5 header + 255 data) * 2 because of byte stuffing
#define SHDLC_FRAME_MAX_RX_FRAME_SIZE (2 + 5 + 255)
#define SHDLC_FRAME_MAX_RX_STUFFED_FRAME_SIZE (2 + (5 + 255) * 2)

#define RX_DELAY_MS 20

//typedef struct {
//    uint8_t* data;
//    uint16_t offset;
//    uint8_t checksum;
//} sensirion_shdlc_buf_t;

typedef struct {
    uint8_t addr;
    uint8_t cmd;
    uint8_t state;
    uint8_t length;
    uint8_t data[SHDLC_FRAME_MAX_RX_FRAME_SIZE];
} sensirion_shdlc_rx_t;

/**
 * sensirion_shdlc_tx() - transmit an SHDLC frame
 *
 * @addr:       SHDLC recipient address
 * @cmd:        command parameter
 * @data_len:   data length to send
 * @data:       data to send
 * Return:      0 on success, an error code otherwise
 */
int16_t sensirion_shdlc_tx(uart_dma_tx_t *h, uint8_t addr, uint8_t cmd, uint8_t data_len,
                           const uint8_t* data);

/**
 * sensirion_shdlc_rx() - receive an SHDLC frame
 *
 * Note that the header and data must be discarded on failure
 *
 * @data_len:   max data length to receive
 * @header:     Memory where the SHDLC header containing the sender address,
 *              command, sensor state and data length is stored
 * @data:       Memory where received data is stored
 * Return:      0 on success, an error code otherwise
 */
int16_t sensirion_shdlc_rx(uart_dma_rx_t *h, sensirion_shdlc_rx_t *rx);

/**
 * sensirion_shdlc_xcv() - transceive (transmit then receive) an SHDLC frame
 *
 * Note that rx_header and rx_data must be discarded on failure
 *
 * @addr:           recipient address
 * @cmd:            parameter
 * @tx_data_len:    data length to send
 * @tx_data:        data to send
 * @rx_header:      Memory where the SHDLC header containing the sender address,
 *                  command, sensor state and data length is stored
 * @rx_data:        Memory where the received data is stored
 * Return:          0 on success, an error code otherwise
 */
//int16_t sensirion_shdlc_xcv(uint8_t addr, uint8_t cmd, uint8_t tx_data_len,
//                            const uint8_t* tx_data, uint8_t max_rx_data_len,
//							sensirion_shdlc_rx_t *rx);

/**
 * sensirion_shdlc_add_uint8_t_to_frame() - Add a uint8_t to the frame at
 *                                          offset.
 *
 * @param tx_frame Pointer to buffer in which the write frame will be prepared.
 *                 Caller needs to make sure that there is enough space left in
 *                 the buffer pointed to by the data member after offset in
 *                 tx_frame, to write the data.
 * @param data     uint8_t to be written into the frame.
 */
//void sensirion_shdlc_add_uint8_t_to_frame(
//    struct sensirion_shdlc_buffer* tx_frame, uint8_t data);

/**
 * sensirion_shdlc_begin_frame() - Initialize buffer and add the first three
 *                                 fixed-use data bytes to it.
 *
 * @param tx_frame    Pointer to struct sensirion_shdlc_buffer, all members will
 *                    be initialized in this function.
 * @param buffer      The pointer to a big enough buffer to write the whole
 *                    tx_frame. Caller needs to initialize this buffer.
 * @param command     Command to be written into the frame.
 * @param address     Address to be written into the frame.
 * @param data_length Number of bytes of data to be written into the frame after
 *                    this method.
 */
//void sensirion_shdlc_begin_frame(struct sensirion_shdlc_buffer* tx_frame,
//                                 uint8_t* buffer, uint8_t command,
//                                 uint8_t address, uint8_t data_length);

/**
 * sensirion_shdlc_add_bool_to_frame() - Add a bool to the frame at offset.
 *
 * @param tx_frame Pointer to buffer in which the write frame will be prepared.
 *                 Caller needs to make sure that there is enough space left in
 *                 the buffer pointed to by the data member after offset in
 *                 tx_frame, to write the data.
 * @param data     bool to be written into the frame.
 */
//void sensirion_shdlc_add_bool_to_frame(struct sensirion_shdlc_buffer* tx_frame,
//                                       bool data);

/**
 * sensirion_shdlc_add_uint32_t_to_frame() - Add a uint32_t to the frame at
 *                                           offset.
 *
 * @param tx_frame Pointer to buffer in which the write frame will be prepared.
 *                 Caller needs to make sure that there is enough space left in
 *                 the buffer pointed to by the data member after offset in
 *                 tx_frame, to write the data.
 * @param data     uint32_t to be written into the frame.
 */
//void sensirion_shdlc_add_uint32_t_to_frame(
//    struct sensirion_shdlc_buffer* tx_frame, uint32_t data);

/**
 * sensirion_shdlc_add_int32_t_to_frame() - Add a int32_t to the frame at
 *                                          offset.
 *
 * @param tx_frame Pointer to buffer in which the write frame will be prepared.
 *                 Caller needs to make sure that there is enough space left in
 *                 the buffer pointed to by the data member after offset in
 *                 tx_frame, to write the data.
 * @param data     int32_t to be written into the frame.
 */
//void sensirion_shdlc_add_int32_t_to_frame(
//    struct sensirion_shdlc_buffer* tx_frame, int32_t data);

/**
 * sensirion_shdlc_add_uint16_t_to_frame() - Add a uint16_t to the frame at
 *                                          offset.
 *
 * @param tx_frame Pointer to buffer in which the write frame will be prepared.
 *                 Caller needs to make sure that there is enough space left in
 *                 the buffer pointed to by the data member after offset in
 *                 tx_frame, to write the data.
 * @param data     uint16_t to be written into the frame.
 */
//void sensirion_shdlc_add_uint16_t_to_frame(
//    struct sensirion_shdlc_buffer* tx_frame, uint16_t data);

/**
 * sensirion_shdlc_add_int16_t_to_frame() - Add a int16_t to the frame at
 *                                         offset.
 *
 * @param tx_frame Pointer to buffer in which the write frame will be prepared.
 *                 Caller needs to make sure that there is enough space left in
 *                 the buffer pointed to by the data member after offset in
 *                 tx_frame, to write the data.
 * @param data     int16_t to be written into the frame.
 */
//void sensirion_shdlc_add_int16_t_to_frame(
//    struct sensirion_shdlc_buffer* tx_frame, int16_t data);

/**
 * sensirion_shdlc_add_float_to_frame() - Add a float to the frame at offset.
 *
 * @param tx_frame Pointer to buffer in which the write frame will be prepared.
 *                 Caller needs to make sure that there is enough space left in
 *                 the buffer pointed to by the data member after offset in
 *                 tx_frame, to write the data.
 * @param data     float to be written into the frame.
 */
//void sensirion_shdlc_add_float_to_frame(struct sensirion_shdlc_buffer* tx_frame,
//                                        float data);

/**
 * sensirion_shdlc_add_bytes_to_frame() - Add a byte array to the frame at
 *                                        offset.
 *
 * @param tx_frame    Pointer to buffer in which the write frame will be
 *                    prepared. Caller needs to make sure that there is enough
 *                    space left in the buffer pointed to by the data member
 *                    after offset in tx_frame, to write the data.
 * @param data        Pointer to data to be written into the frame.
 * @param data_length Number of bytes to be written into the frame.
 */
//void sensirion_shdlc_add_bytes_to_frame(struct sensirion_shdlc_buffer* tx_frame,
//                                        const uint8_t* data,
//                                        uint16_t data_length);

/**
 * sensirion_shdlc_finish_frame() - Write closing part of the frame.
 *
 * @param tx_frame Pointer to buffer in which the write frame will be prepared.
 *                 Caller needs to make sure that there is enough space left
 *                 in the buffer pointed to by the data member after offset
 *                 in tx_frame, to write 3 bytes.
 */
//void sensirion_shdlc_finish_frame(struct sensirion_shdlc_buffer* tx_frame);

/**
 * sensirion_shdlc_tx_frame() - Transmit the SHDLC frame.
 *
 * @param tx_frame    Pointer to buffer in which the write frame was prepared.
 *
 * @return            NO_ERROR on success, an error code otherwise.
 * @deprecated        This function should not be used with new drivers. Use the
 *                    function sensirion_shdlc_write_request instead!
 */
//int16_t sensirion_shdlc_tx_frame(struct sensirion_shdlc_buffer* tx_frame);

/**
 * sensirion_shdlc_rx_inplace() - Receive an SHDLC frame in a prepared buffer.
 *
 * @note The header and data must be discarded on failure
 *
 * @param rx_frame             Pointer to buffer in which the RX frame will be
 *                             received in and the return data will be stored
 *                             in. Offset and checksum member will be
 *                             initialized by this function, but rx_frame->data
 *                             needs to point to a buffer big enough to store
 *                             the whole unprocessed RX frame in.
 * @param expected_data_length Expected data amount to receive.
 * @param header               Memory where the SHDLC header containing the
 *                             sender address, command, state and data_length
 *                             is stored.
 *
 * @return            NO_ERROR on success, an error code otherwise
 * @deprecated        This function should not be used with new drivers. Use the
 *                    function sensirion_shdlc_read_response instead!
 */
//int16_t sensirion_shdlc_rx_inplace(struct sensirion_shdlc_buffer* rx_frame,
//                                   uint8_t expected_data_length,
//                                   struct sensirion_shdlc_rx_header* header);

#ifdef __cplusplus
}
#endif

#endif /* SENSIRION_SHDLC_H */
