dwatman/weather-station/Firmware/test_temperature/Core/Src/stm32wbaxx_it.c

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

/* Includes ------------------------------------------------------------------*/
#include "main.h"
#include "stm32wbaxx_it.h"
/* USER CODE BEGIN Includes */
#include "i2c_util.h"
#include "sht40.h"
/* USER CODE END Includes */

/* USER CODE BEGIN PV */
extern i2c_t i2c1_info;
extern sht40_t sht40_device;
/* USER CODE END PV */

/* External variables --------------------------------------------------------*/

/******************************************************************************/
/*           Cortex Processor Interruption and Exception Handlers          */
/******************************************************************************/
/**
  * @brief This function handles Non maskable interrupt.
  */
void NMI_Handler(void)
{
  /* USER CODE BEGIN NonMaskableInt_IRQn 1 */
   while (1)
  {
  }
  /* USER CODE END NonMaskableInt_IRQn 1 */
}

/**
  * @brief This function handles Hard fault interrupt.
  */
void HardFault_Handler(void)
{
  while (1)
  {
  }
}

/**
  * @brief This function handles Memory management fault.
  */
void MemManage_Handler(void)
{
  while (1)
  {
  }
}

/**
  * @brief This function handles Prefetch fault, memory access fault.
  */
void BusFault_Handler(void)
{
  while (1)
  {
  }
}

/**
  * @brief This function handles Undefined instruction or illegal state.
  */
void UsageFault_Handler(void)
{
  while (1)
  {
  }
}

/**
  * @brief This function handles System service call via SWI instruction.
  */
void SVC_Handler(void)
{
}

/**
  * @brief This function handles Debug monitor.
  */
void DebugMon_Handler(void)
{
}

/**
  * @brief This function handles Pendable request for system service.
  */
void PendSV_Handler(void)
{
}

/**
  * @brief This function handles System tick timer.
  */
void SysTick_Handler(void)
{
  /* USER CODE BEGIN SysTick_IRQn 0 */
	if (sht40_device.timeout > 0) sht40_device.timeout--;
  /* USER CODE END SysTick_IRQn 0 */
  HAL_IncTick();
}

/******************************************************************************/
/* STM32WBAxx Peripheral Interrupt Handlers                                    */
/* Add here the Interrupt Handlers for the used peripherals.                  */
/* For the available peripheral interrupt handler names,                      */
/* please refer to the startup file (startup_stm32wbaxx.s).                    */
/******************************************************************************/

/**
  * @brief This function handles I2C1 Event interrupt.
  */
void I2C1_EV_IRQHandler(void)
{
  /* USER CODE BEGIN I2C1_EV_IRQn 0 */
	BSP_LED_On(LD3);
	//printf("I2C1_EV_IRQ\n");
  /* USER CODE END I2C1_EV_IRQn 0 */
  /* USER CODE BEGIN I2C1_EV_IRQn 1 */
//	if (LL_I2C_IsActiveFlag_TC(I2C1)) {
//		printf("    TC\n");
//	}
//	if (LL_I2C_IsActiveFlag_TCR(I2C1)) {
//		printf("    TCR\n");
//	}
	if (LL_I2C_IsActiveFlag_NACK(I2C1)) {
		LL_I2C_ClearFlag_NACK(I2C1);
		printf("    NACK\n");
	}
	if (LL_I2C_IsActiveFlag_RXNE(I2C1)) {
		uint8_t data = LL_I2C_ReceiveData8(I2C1);
		//printf("    RXNE: [%u] = %02X\n", i2c1_info.index, data);
		if (i2c1_info.state == I2C_STATE_READING) {
			i2c1_info.buf[i2c1_info.index] = data;
			i2c1_info.index++;

			if (i2c1_info.index == i2c1_info.length) {
				i2c1_info.state = I2C_STATE_IDLE;
				i2c1_info.done = 1;
			}
		}
	}
	if (LL_I2C_IsActiveFlag_STOP(I2C1)) {
		LL_I2C_ClearFlag_STOP(I2C1);
		//printf("    STOP\n");
	}
	BSP_LED_Off(LD3);
  /* USER CODE END I2C1_EV_IRQn 1 */
}

/**
  * @brief This function handles I2C1 Error interrupt.
  */
void I2C1_ER_IRQHandler(void)
{
  /* USER CODE BEGIN I2C1_ER_IRQn 0 */
	printf("I2C1_ER_IRQ\n");
  /* USER CODE END I2C1_ER_IRQn 0 */
  /* USER CODE BEGIN I2C1_ER_IRQn 1 */
	i2c1_info.state = I2C_STATE_ERROR;
	if (LL_I2C_IsActiveFlag_BERR(I2C1)) {
		printf("    BERR\n");
	}
	if (LL_I2C_IsActiveFlag_ARLO(I2C1)) {
		printf("    ARLO\n");
	}
	if (LL_I2C_IsActiveFlag_OVR(I2C1)) {
		printf("    OVR\n");
	}
  /* USER CODE END I2C1_ER_IRQn 1 */
}
