dwatman/weather-station/Firmware/display/STM32CubeIDE/CM7/Application/User/ui/ui_io.h

#ifndef APPLICATION_USER_UI_UI_IO_H_
#define APPLICATION_USER_UI_UI_IO_H_

const char *get_var_time_str();
const char *get_var_ampm_str();
const char *get_var_t1_str();
const char *get_var_t2_str();
const char *get_var_h1_str();
const char *get_var_h2_str();
const char *get_var_press_str();
const char *get_var_lux_str();
const char *get_var_rssi_str();
const char *get_var_bl_str();
int32_t get_var_soil1_int();
int32_t get_var_soil2_int();
int32_t get_var_soil3_int();
int32_t get_var_soil4_int();
int32_t get_var_soil5_int();
int32_t get_var_soil6_int();

void set_var_time_str(const char *value);
void set_var_ampm_str(const char *value);
void set_var_t1_str(const char *value);
void set_var_t2_str(const char *value);
void set_var_h1_str(const char *value);
void set_var_h2_str(const char *value);
void set_var_press_str(const char *value);
void set_var_lux_str(const char *value);
void set_var_rssi_str(const char *value);
void set_var_bl_str(const char *value);
void set_var_soil1_int(int32_t value);
void set_var_soil2_int(int32_t value);
void set_var_soil3_int(int32_t value);
void set_var_soil4_int(int32_t value);
void set_var_soil5_int(int32_t value);
void set_var_soil6_int(int32_t value);

void set_time(uint32_t val);
void set_t1(float val);
void set_t2(float val);
void set_h1(float val);
void set_h2(float val);
void set_press(float val);
void set_lux(float val);
void set_rssi(int val);
void set_bl(int val);

void set_wifi_colour(lv_color_t new_colour);
void set_garage_state(int32_t value);

#endif
