dwatman/weather-station/(commit log)

2025-09-27 Added gitignore for STM32
2025-09-27 Added LED and button connections
2025-09-27 Added simulated temperature measurement. Added persistent storage for Zigbee reconnection
2025-09-27 Changed to reduced function device, endpoint only to reduce code size and complexity
2025-09-27 Created project to test particle sensor
2025-09-28 Added DMA USART transmit function
2025-09-28 Added DMA USART receive functions
2025-09-29 Can send reset command, DMA RX works but not looping
    [main.c, sensirion_shdlc.c, test_particle.ioc, usart_dma.c, usart_dma.h]
2025-09-30 Trying to get circular DMA working, still fails
    [main.c, stm32wbaxx_it.c, test_particle.ioc, usart_dma.c, usart_dma.h]
2025-09-30 Changed DMA mode to use circular linked list
2025-09-30 Circular DMA is working
2025-10-01 Cleaned up some DMA read functions
2025-10-04 Clear new_data when there is not enough data for the full packet. Moved the buffer for raw bytes to a global to prevent reallocating every time.
    [sensirion_shdlc.c]
2025-10-04 Improved skipping to next marker
    [sensirion_shdlc.c, sensirion_shdlc.h]
2025-10-05 Created project for interfacing with SHT40 temperature/humidity sensor
2025-10-05 Added initial I2C functions
2025-10-05 Increased I2C speed to 400kHz, read/write is working
2025-10-05 Restructured to separate the SHT40 from I2C bus so other sensors can share the bus.
2025-10-10 Created KiCad library and initial project with available parts
    [sensors_indoor.kicad_pcb, sensors_indoor.kicad_sch]
2025-10-12 Added OPT4001 ambient light sensor, fixed antenna clearance for STM32WBA
2025-10-12 Adjusted gitignore for KiCad
2025-10-12 Arranged sensors on PCB, added MRAM and USB-C socket
    [sensors_indoor.kicad_pcb, sensors_indoor.kicad_sch]
2025-10-12 Split schematic into 3 for clarity
    [indoor_MCU.kicad_sch, indoor_sensors.kicad_sch, sensors_indoor.kicad_pcb, sensors_indoor.kicad_sch]
2025-10-14 Refined antenna clearance for STM32WBA based on dev board
2025-10-14 Added mounting holes and power supply
    [indoor_MCU.kicad_sch, indoor_sensors.kicad_sch, sensors_indoor.kicad_pcb, sensors_indoor.kicad_sch]
2025-10-15 Swapped sides of everything and started routing
    [indoor_MCU.kicad_sch, indoor_sensors.kicad_sch, sensors_indoor.kicad_pcb, sensors_indoor.kicad_sch]
2025-10-16 Added IR receiver and LED to library
2025-10-16 Updated PCB with SMD IR tx/rx
    [indoor_MCU.kicad_sch, indoor_sensors.kicad_sch, sensors_indoor.kicad_pcb]
2025-10-17 Changed ambient light sensor
2025-10-17 Fixed footprints for IR LED and MCU
2025-10-17 Completed schematic, done most routing
    [indoor_MCU.kicad_sch, indoor_sensors.kicad_sch, sensors_indoor.kicad_pcb, sensors_indoor.kicad_sch]
2025-10-18 Added preliminary energy harvesting circuit for solar power
    [solar_power.kicad_pcb, solar_power.kicad_sch]
2025-10-19 Improved pressure sensor footprint
    [indoor_sensors.kicad_sch, sensors_indoor.kicad_pcb]
2025-10-20 Placed designators on PCB
    [sensors_indoor.kicad_pcb]
2025-10-20 Restructured directories
    [indoor_MCU.kicad_sch, indoor_sensors.kicad_sch, sensors_indoor.kicad_pcb, sensors_indoor.kicad_sch, solar_power.kicad_pcb, solar_power.kicad_sch]
2025-10-20 Expand README with sensor and module details
    Added specifications for wireless module, sensors, and sensor units.
2025-10-21 Changed switch to SMD type
    [indoor_MCU.kicad_sch, sensors_indoor.kicad_pcb]
2025-10-21 Added UV sensor
    [indoor_MCU.kicad_sch, indoor_sensors.kicad_sch, sensors_indoor.kicad_pcb]
2025-10-22 Completed routing connections
    [indoor_MCU.kicad_sch, indoor_sensors.kicad_sch, sensors_indoor.kicad_pcb]
2025-10-22 Added 18650 battery holder to library and solar PCB
    [solar_power.kicad_pcb, solar_power.kicad_sch]
2025-10-29 Renamed PCB test project
    [MCU.kicad_sch, sensors.kicad_sch, sensors_test.kicad_pcb, sensors_test.kicad_sch]
2025-10-29 Added SPI version of FRAM to library
2025-11-05 Created indoor sensor PCB
    [MCU.kicad_sch, sensors.kicad_sch, sensors_indoor.kicad_pcb, sensors_indoor.kicad_sch]
2025-11-05 Changed PTC fuse part
    [sensors_indoor.kicad_pcb, sensors_indoor.kicad_sch]
2025-11-06 Added LEDs
    [MCU.kicad_sch, sensors_indoor.kicad_pcb]
2025-11-08 Started new PCB for wifi module
    [display_wifi.kicad_pcb, display_wifi.kicad_sch]
2025-11-09 Rotated USB-C to exit at bottom, added debug pins for I2C
    [MCU.kicad_sch, sensors_indoor.kicad_pcb]
2025-11-09 Added filtering and connectors to solar PCB with 3D models
    [solar_power.kicad_pcb, solar_power.kicad_sch]
2025-11-10 Added light sensor, IR remote sensor, test connectors, and routed PCB for display
    [display_wifi.kicad_pcb, display_wifi.kicad_sch]
2025-11-11 Added passthrough for power and SWD to simplify connections. Added part numbers.
    [display_wifi.kicad_pcb, display_wifi.kicad_sch, passthrough.kicad_sch]
2025-11-24 Added part numbers for cables
    [passthrough.kicad_sch]
2025-11-24 Added skeleton PCB project for outdoor sensor
    [MCU.kicad_sch, sensors.kicad_sch, sensors_outdoor.kicad_pcb, sensors_outdoor.kicad_sch]
2025-11-24 Initial IOC for indoor sensor
2025-11-25 Moved backlight PWM, I2C4, USART1 to CM4. Removed code for touchscreen
2025-11-26 Added UART4 with FIFO for debug output
2025-11-26 Added initialisation of OPT4001 ambient light sensor
2025-11-26 Added ISR-based printf to serial port for debug
2025-11-26 Fixed printf
2025-11-27 Updated PCB to v1.1
    [display_wifi.kicad_pcb, display_wifi.kicad_sch, passthrough.kicad_sch]
2025-11-27 Add mutex to LVGL so it doesn't get stuck
    [main.c]
2025-11-28 Upgraded STM32CubeMX version
2025-11-29 Enabled FIFO and DMA receive for USART1
2025-11-29 Set up DMA receive of serial data from WiFi module
2025-12-01 Added pressure, backlight, 4x soil measurements to display
2025-12-04 Added external interrupt from pressure sensor
2025-12-04 Correct reception of data from MQTT
    [main.c, main.h, network.c, network.h]
2025-12-05 Added pressure measurement from LPS25HB sensor, integrated
2025-12-05 Round pressure and lux to 1 decimal place
2025-12-10 Fixed problem with detecting OK/ERROR
    [wifi_sm.c]
2025-12-12 Updated display with larger font, 2 more soil sensors, garage door indicator
2025-12-12 Added filtering for pressure readings and fast start of backlight brightness adjustment
2025-12-12 Updated IOC for IR code rception with DMA
2025-12-21 Increased backlight PWM resolution
2025-12-30 [PCB] Changed library over to submodule and updated project
    [display_wifi.kicad_pcb]
2026-01-09 Added automatic reset of WiFi if no data received for a while, or on IR remote "STOP" command. Fixed release build settings.
    [ir_decode.c, main.c, network.c, screens.c, wifi_sm.c]
2026-01-12 Added more checks to stop it getting stuck on startup or when there are wifi issues
    [main.c]
2026-01-17 Added reset if RSSI is low for 1hr
    [main.c, network.c, network.h, wifi_sm.c]
2026-04-01 Generated code with simulated sensors, changed to RFD to fit in RAM.
2026-04-03 Changed power def to mains power
2026-04-05 Fixed hard fault caused by logging function, increased stack size, merged RAM/RAM2. Now connects to coordinator OK
    [main.c, main.h, stm32wbaxx_it.c]
2026-04-08 Increased WPAN memory pool and stack size to prevent crash.
    [app_conf.h, test_zigbee.ioc]
2026-04-09 Attempting to fix null values for custom sensors (not working yet)
2026-04-12 Fixed external converter and illuminance conversion function
    [sensor_data.c]
