dwatman/weather-station/(notices)

Notices in the files:
Firmware/test_temperature/Core/Src/stm32wbaxx_it.c:
Copyright (c) 2025 STMicroelectronics.
All rights reserved.
This software is licensed under terms that can be found in the LICENSE file
Firmware/display/CM7/Core/Src/main.c:
Copyright (c) 2023 STMicroelectronics.
Firmware/test_zigbee/Core/Inc/app_conf.h:
Copyright (c) 2026 STMicroelectronics.
